aleckorver/KVR-ENCDR/README.md

# KVR-ENCDR
For development of hardware/firmware of a custom on axis encoder utilizing MLX90363 and M0+ to create a system with multiple simultaneous common encoder outputs (CANbus, PWM, A Vout, Push - Pull)
