aleckorver/KVR-ENCDR/SAMD21G18/Standard Board/EAGLE FILES/On Axis Encoder.dxf

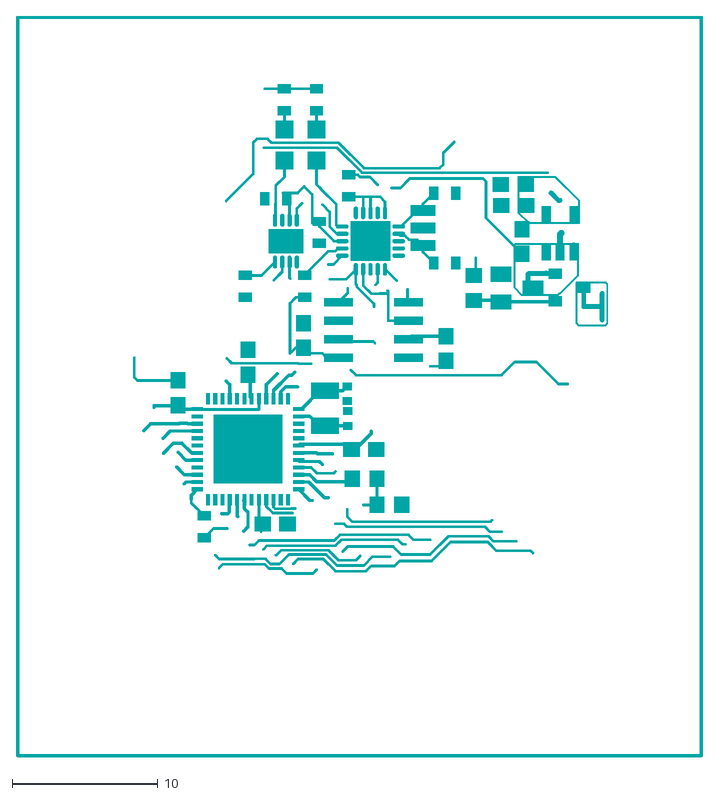
[picture p1: CAD file, 2020-12-15]
SAMD21G18/Standard Board/EAGLE FILES/On Axis Encoder.dxf
47.1 x 50.9
