aleckorver/KVR-ENCDR/STM32/Hardware/3D Models/AEV ENCODER 0.0.1 201219.step

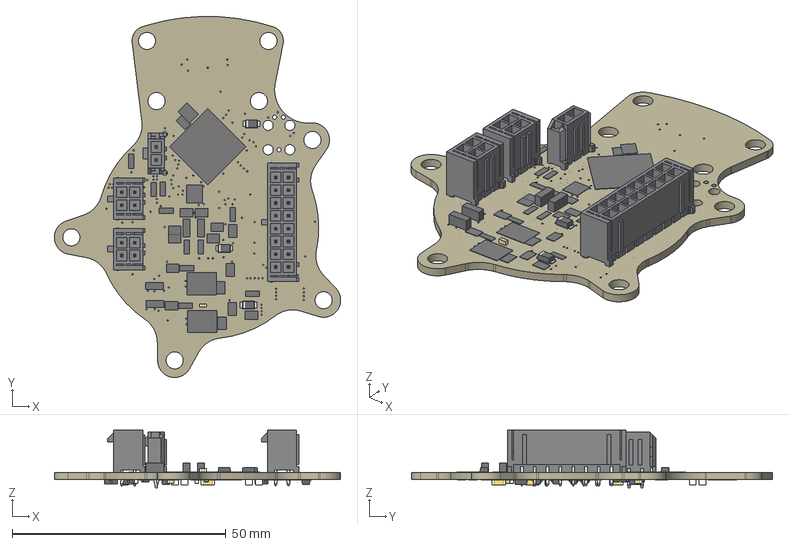
[picture p2: CAD file, 2020-12-28]
STM32/Hardware/3D Models/AEV ENCODER 0.0.1 201219.step
67.1 x 84.5 x 13.6 mm
Board
ICM-20648
SODFL3718X115 x 5
D0008A_N x 2
PG-DSO-8
SOT-23_3L_ONS
SOT23 x 5
SJ_2 x 4
LQFP64_STMLIB
CRY3225-4
C0603 x 31
C1206 x 7
FUSC1608X60N x 3
SO-8_S_LIT
C0603 (2) x 3
R0603 (1) x 42
SOT323-3_NFET x 2
MS5541C
SMC x 2
6620xx11122_PIN x 2
6620xx21122_PIN x 8
6620xx21122_PIN (1) x 8
6620xx21122_PIN2 x 8
CHIPLED_0805 x 10
R0603 x 4
C0603 (1)
