aleckorver/KVR-ENCDR/STM32/Hardware/Schematic PDF/KVR LABS - AEV ENCODER 0.0.1  - 201227.pdf

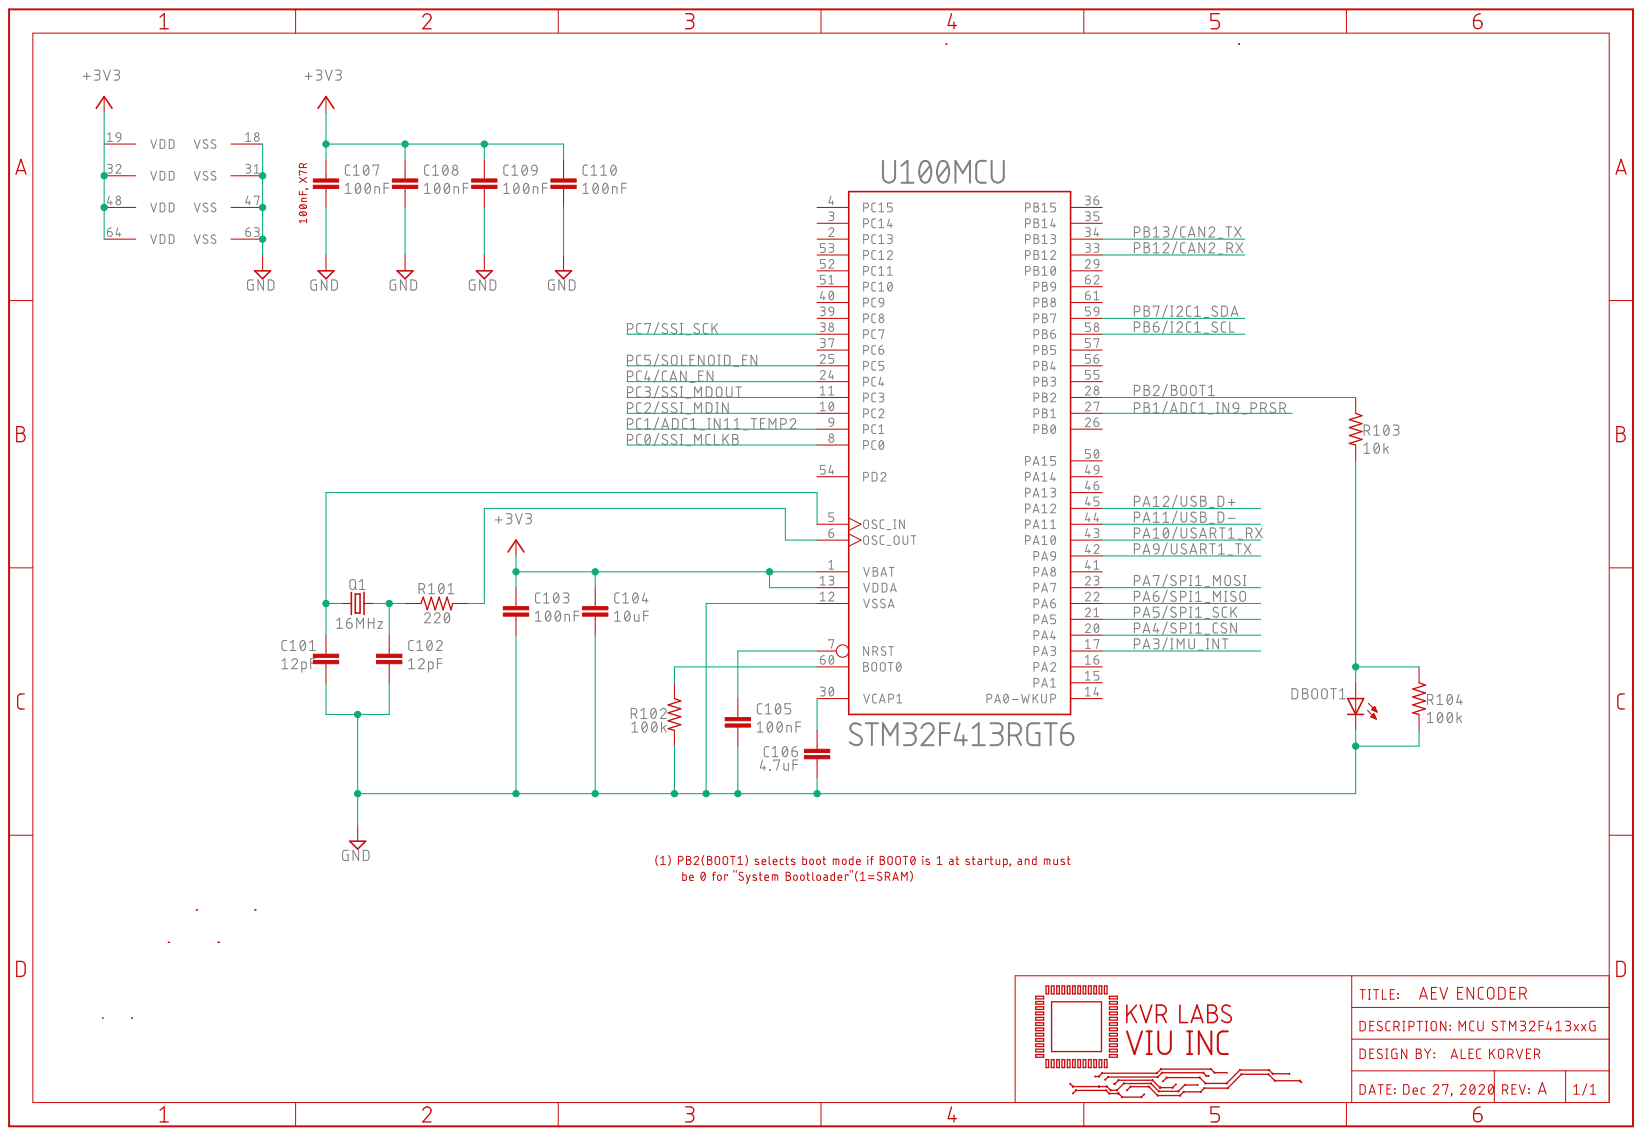
[picture p3: page 1]

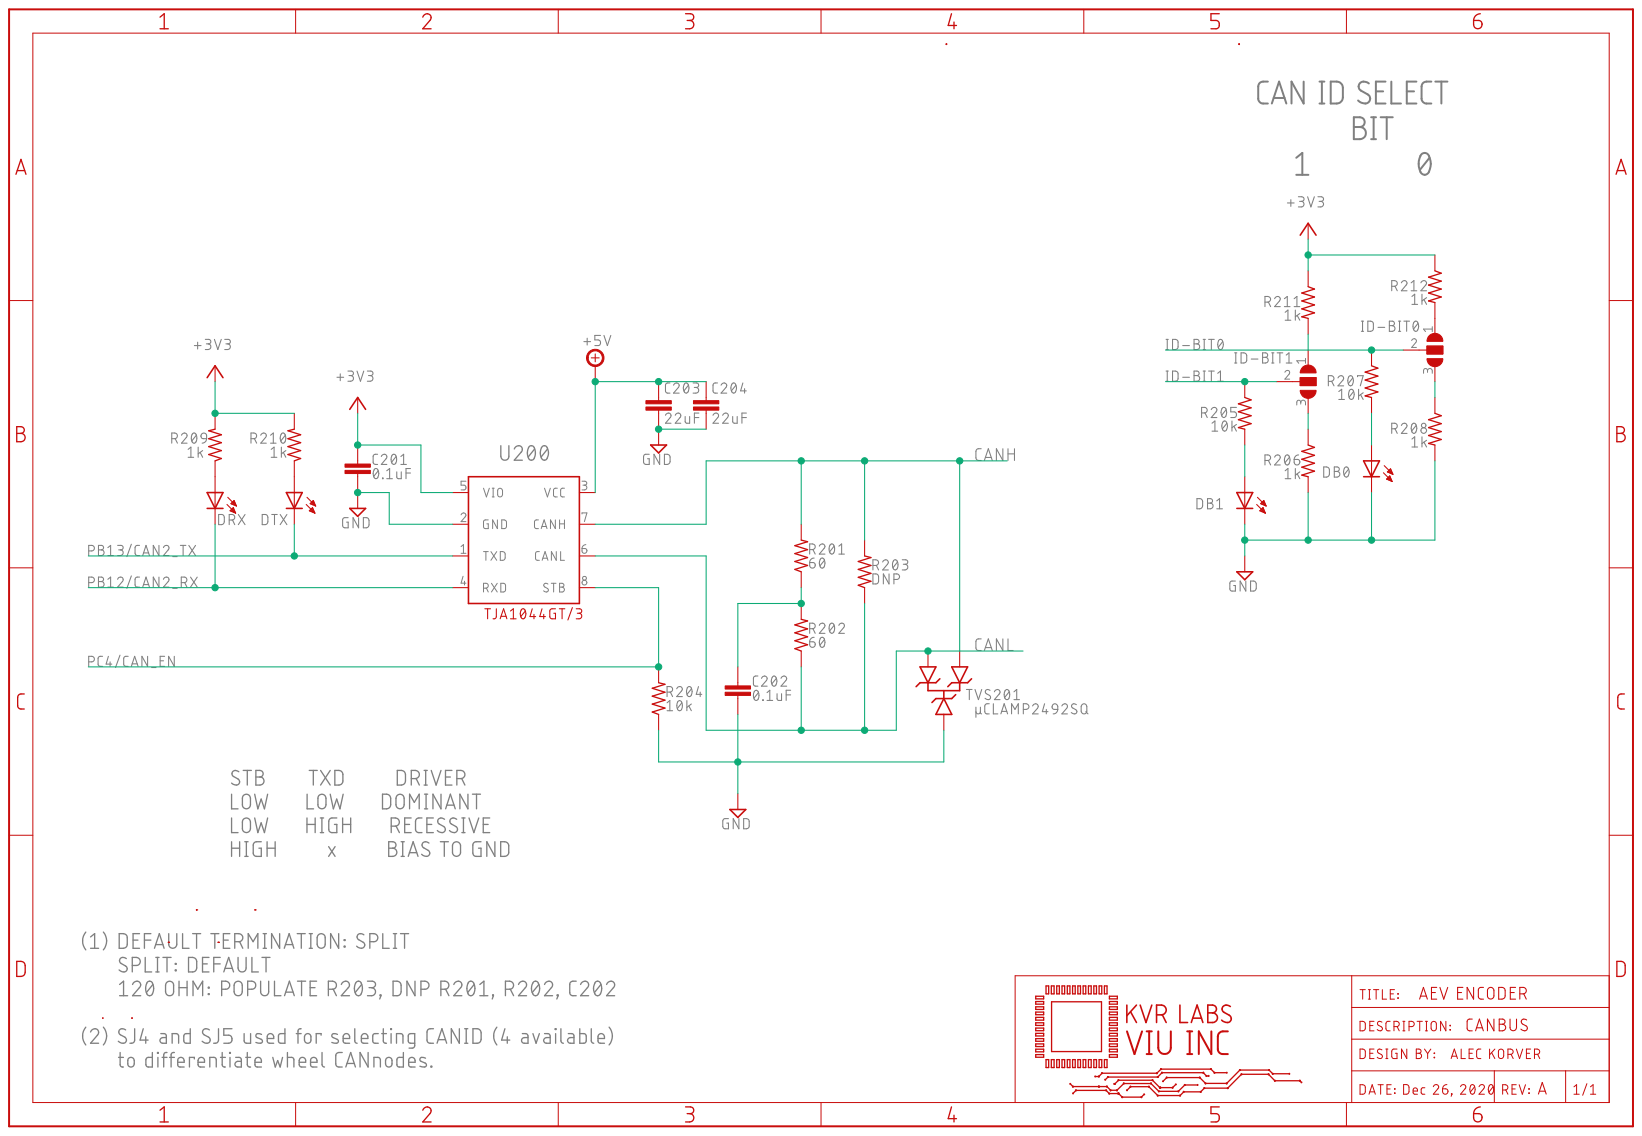
[picture p4: page 2]

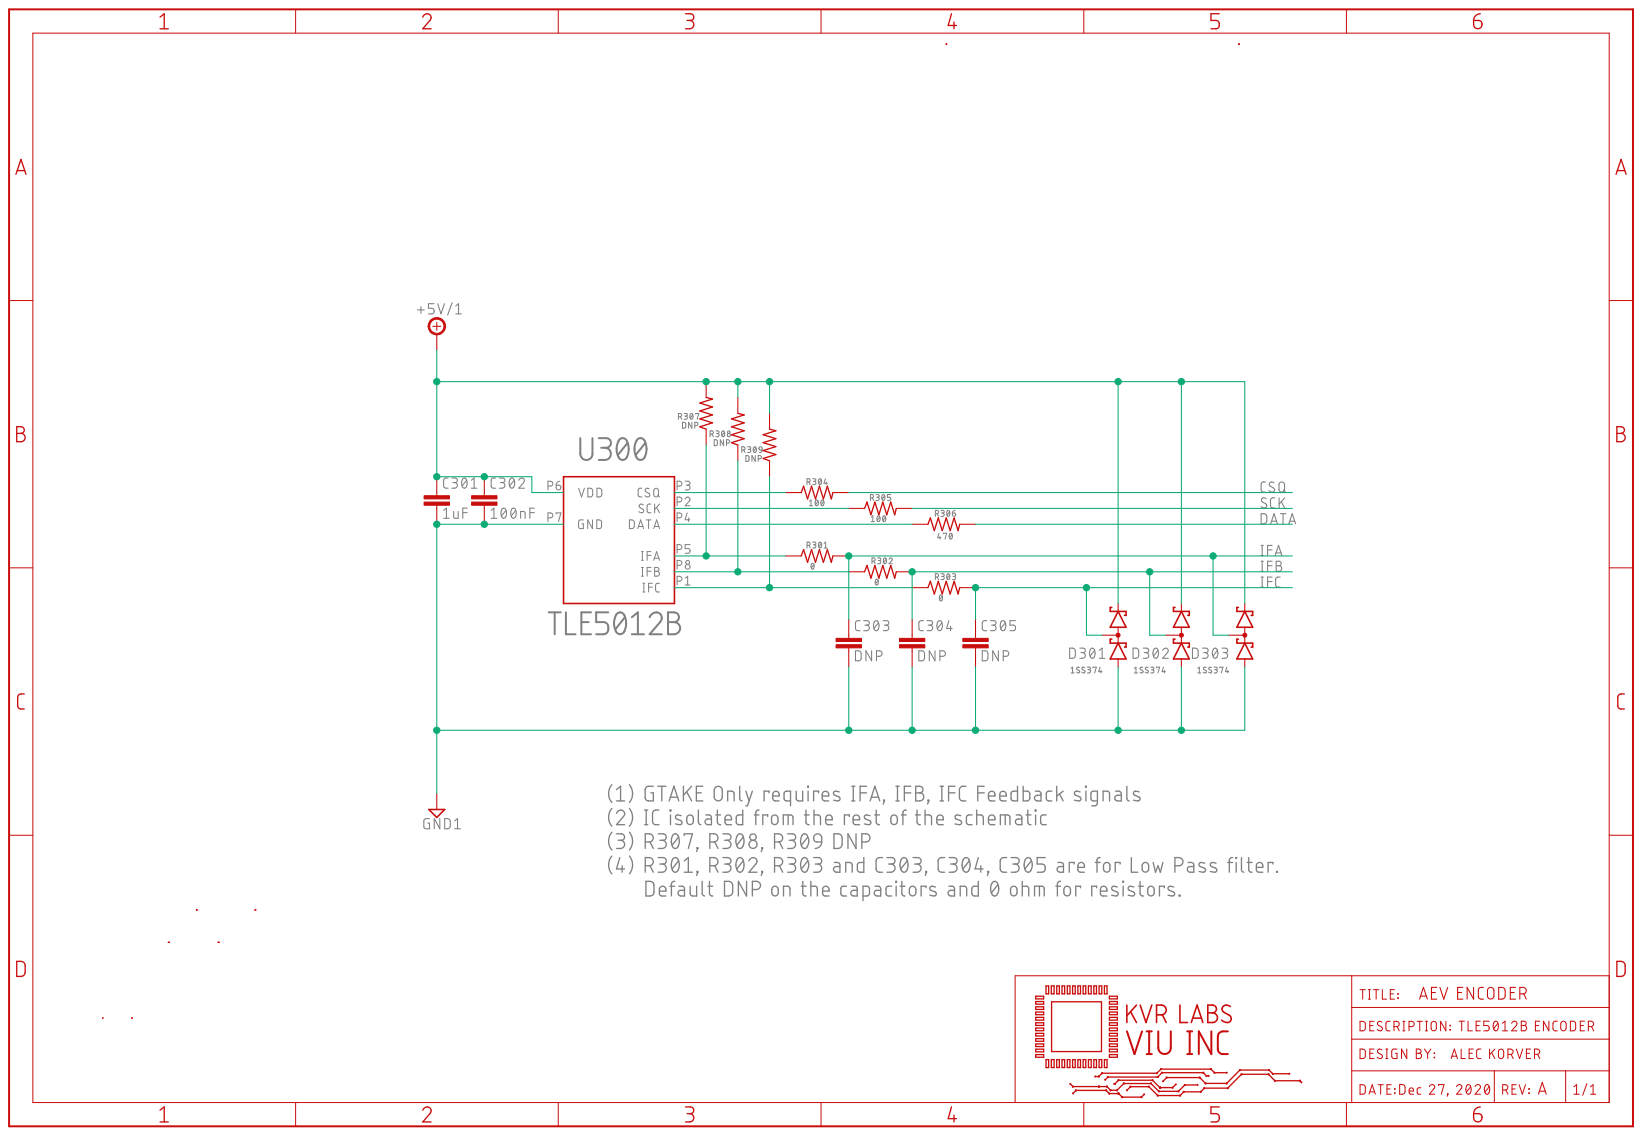
[picture p5: page 3]

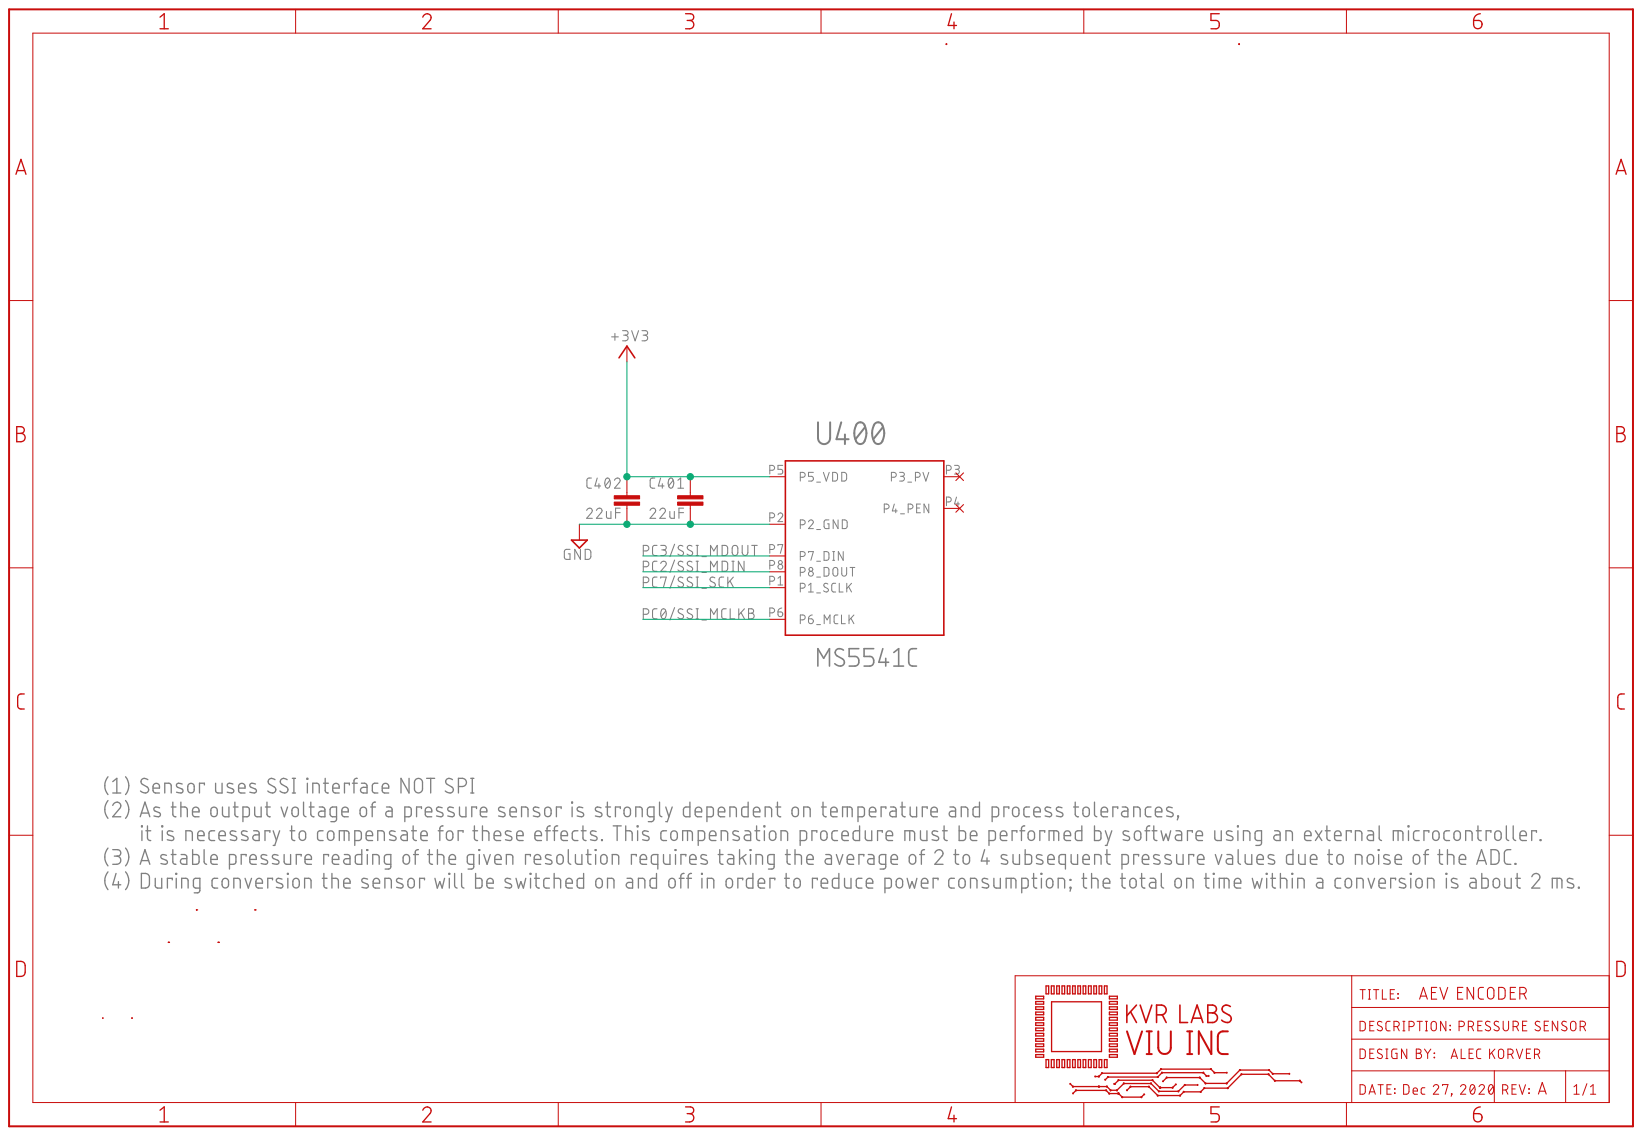
[picture p6: page 4]

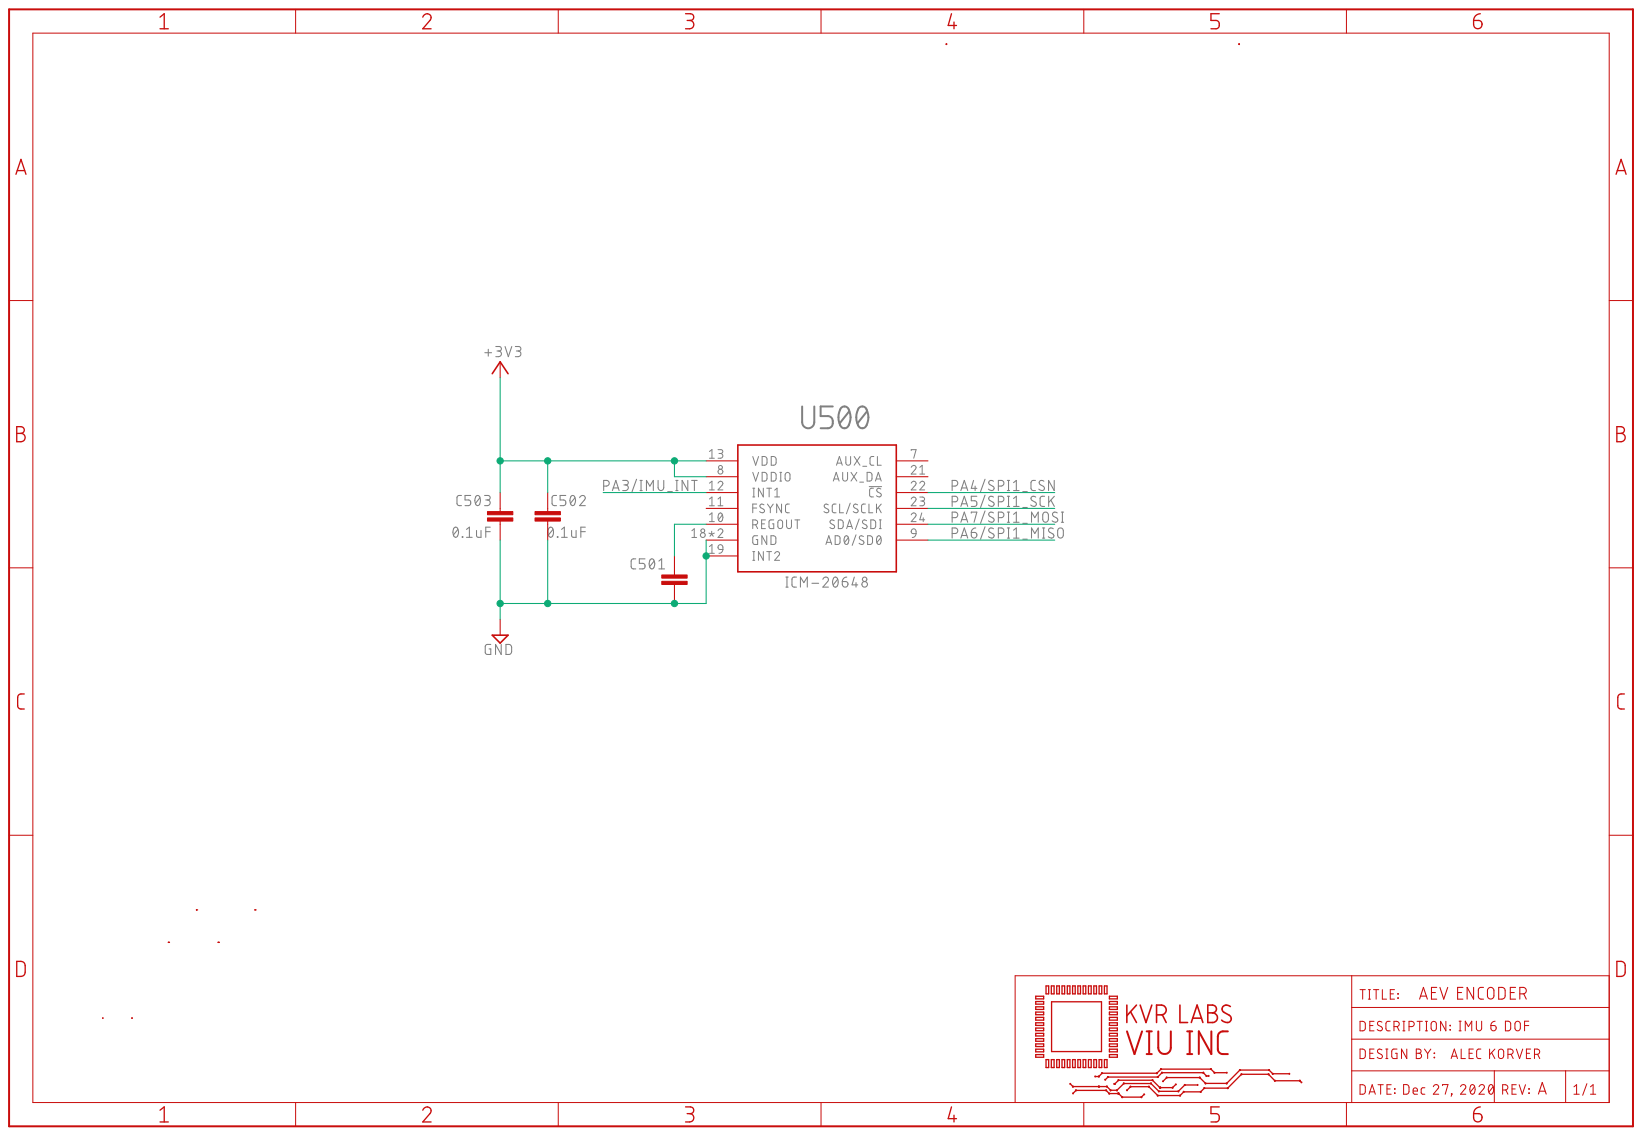
[picture p7: page 5]

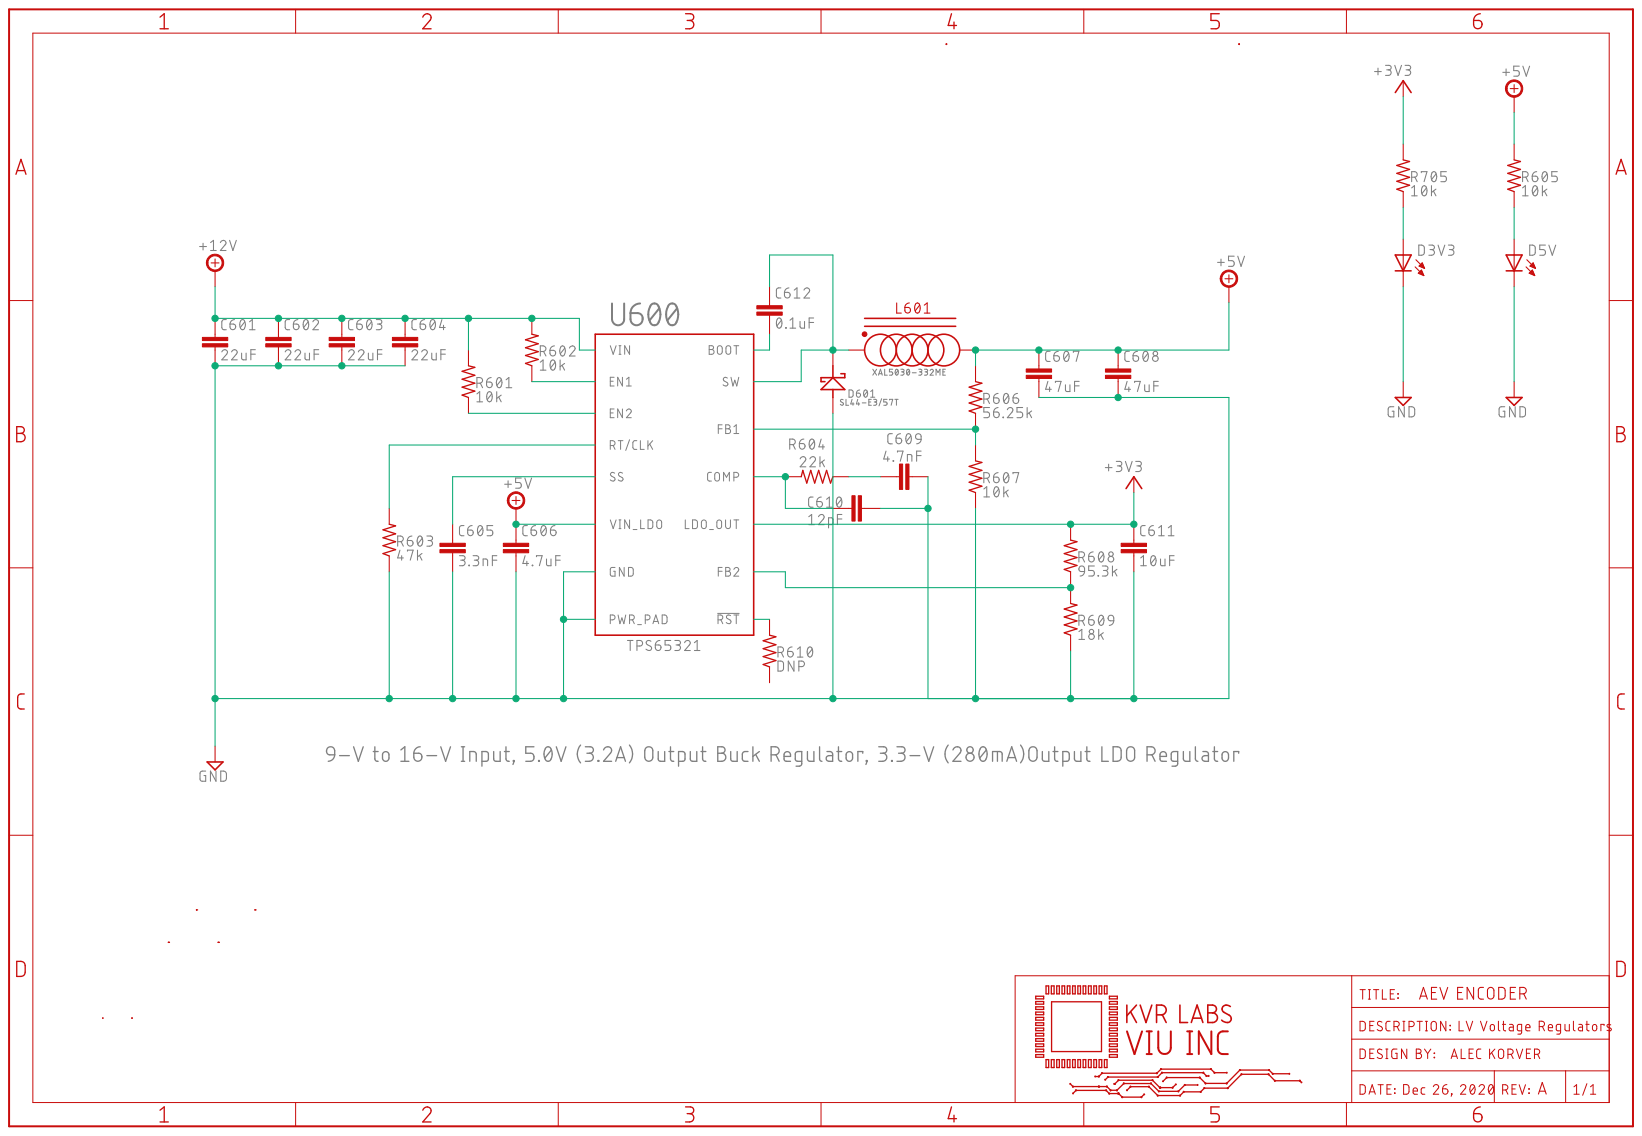
[picture p8: page 6]

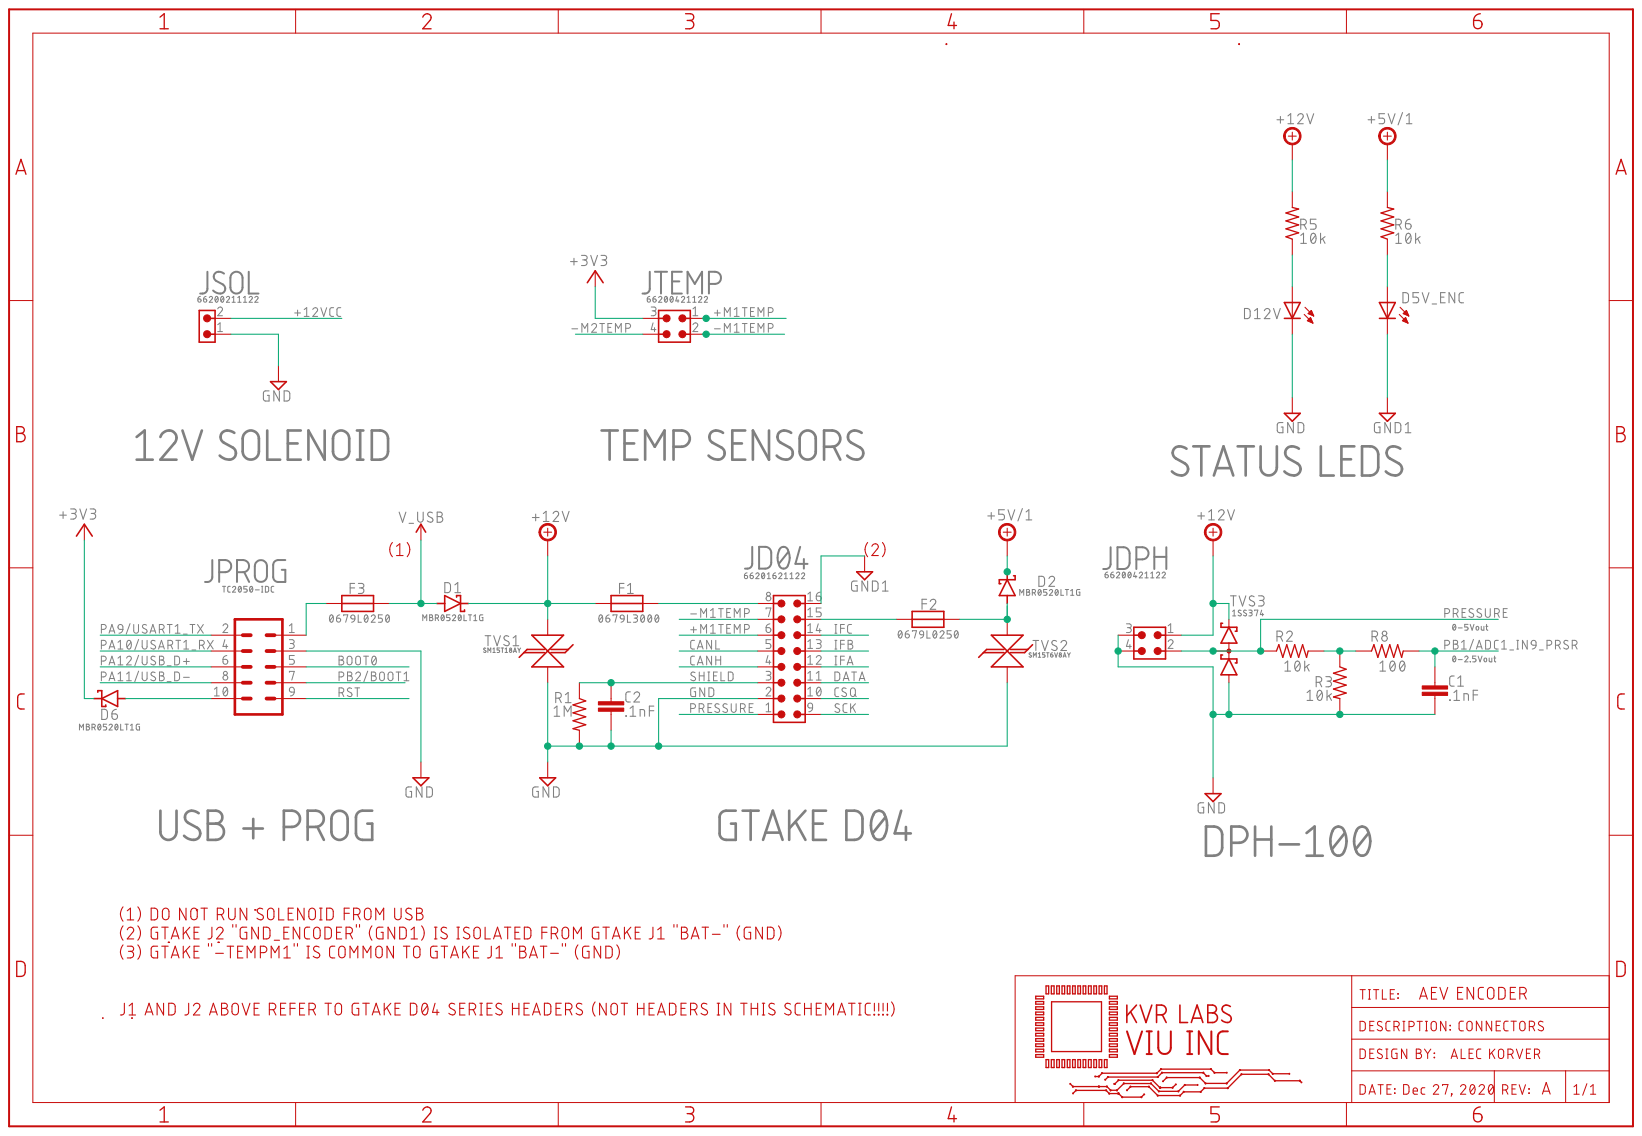
[picture p9: page 7]

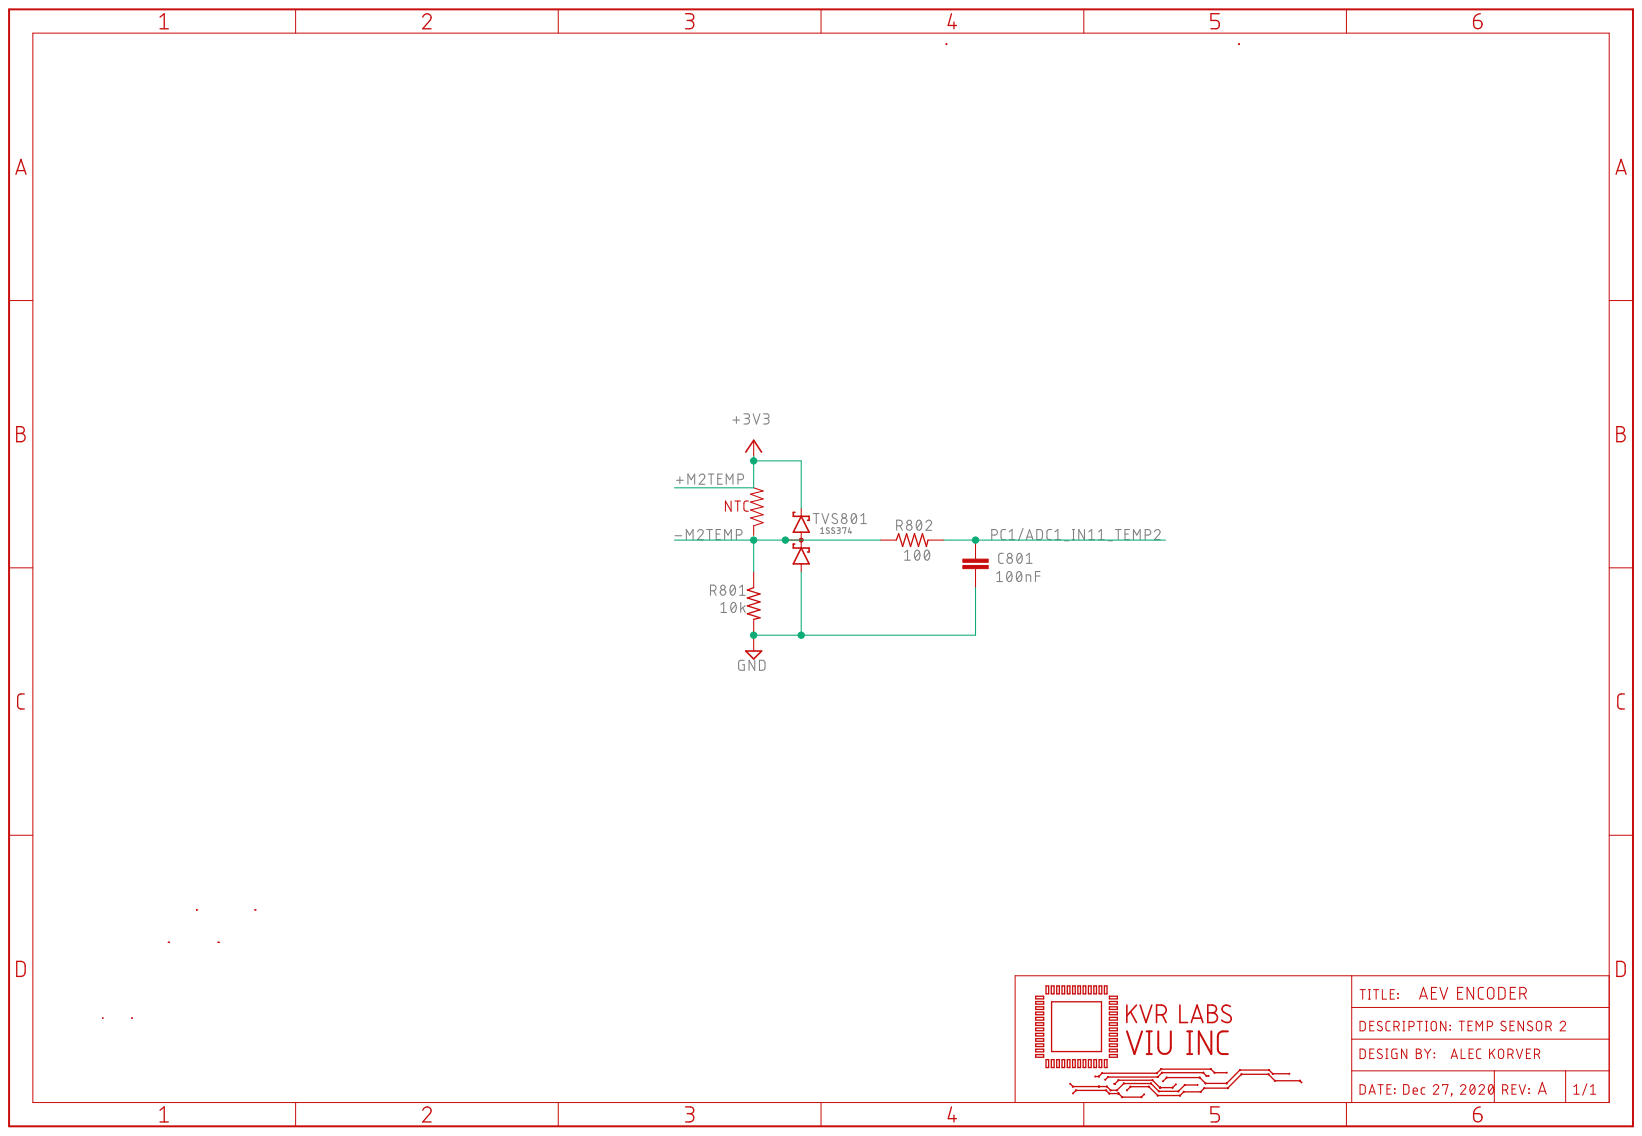
[picture p10: page 8]

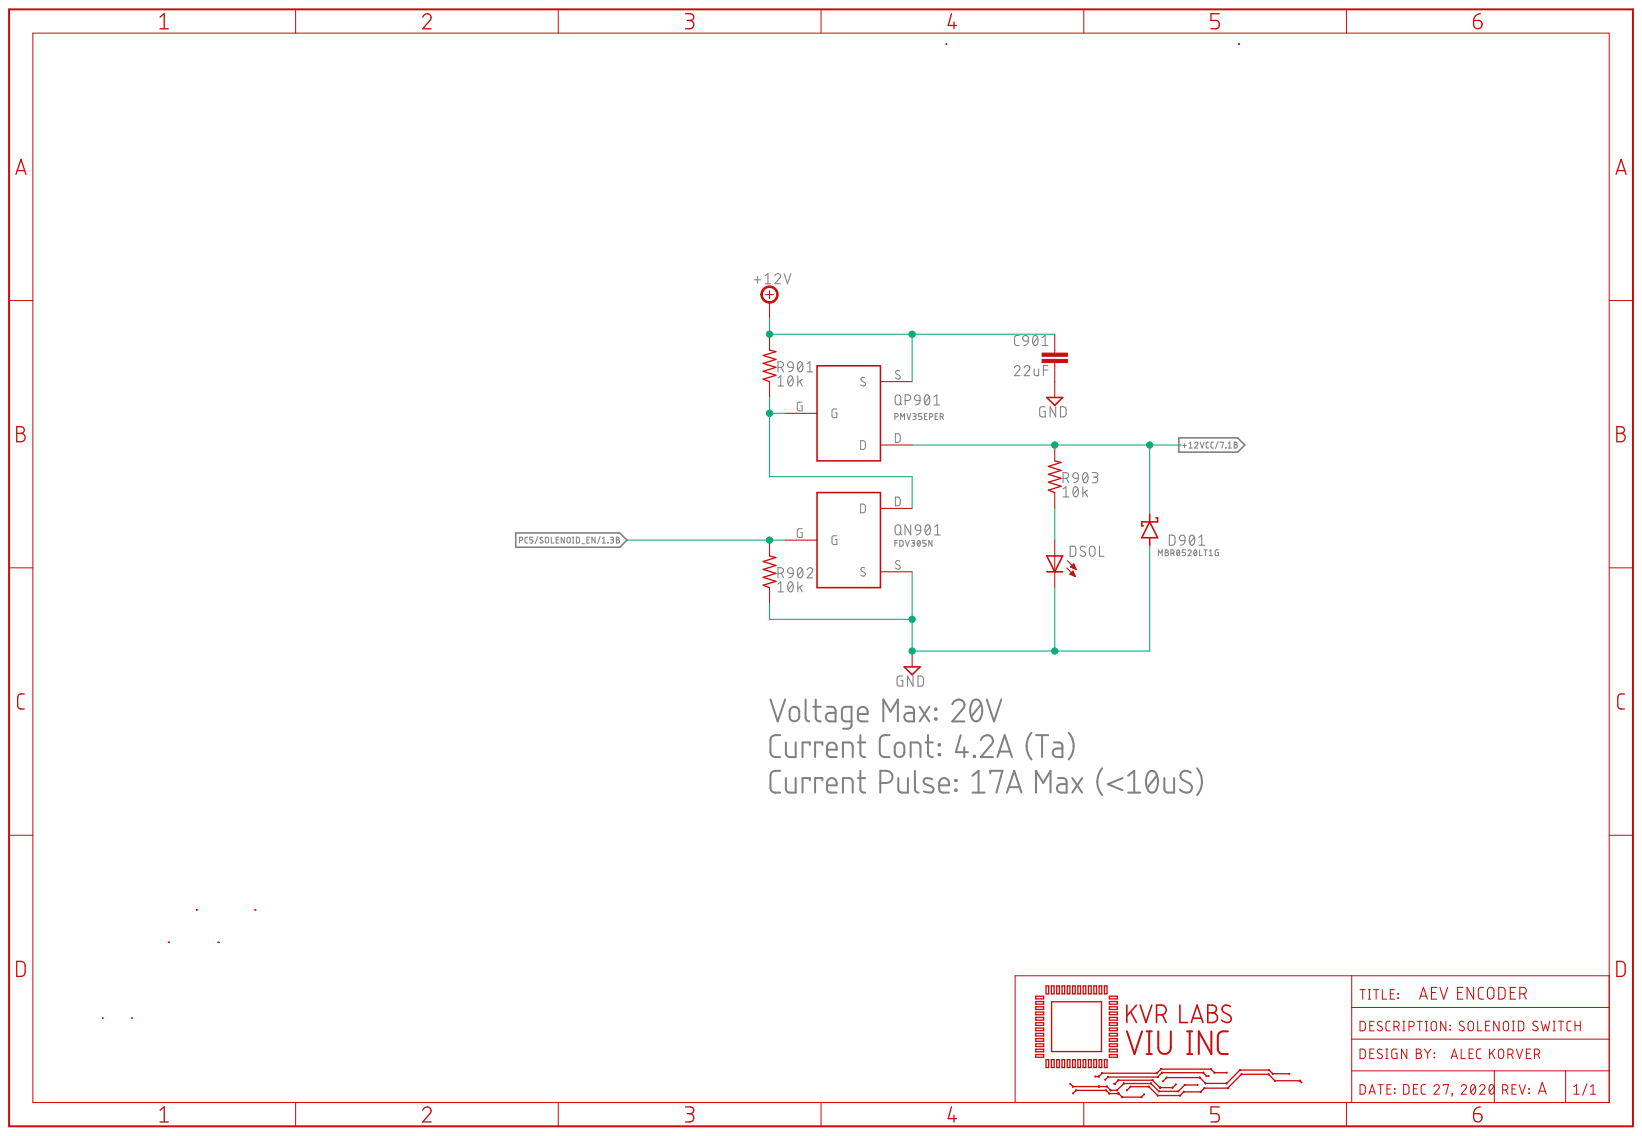
[picture p11: page 9]
