aleckorver/KVR-ENCDR/STM32/Hardware/Eagle Files/KVR LABS - AEV ENCODER 1.01-STM32.brd

## EAGLE design STM32/Hardware/Eagle Files/KVR LABS - AEV ENCODER 1.01-STM32.brd (2020-12-28)

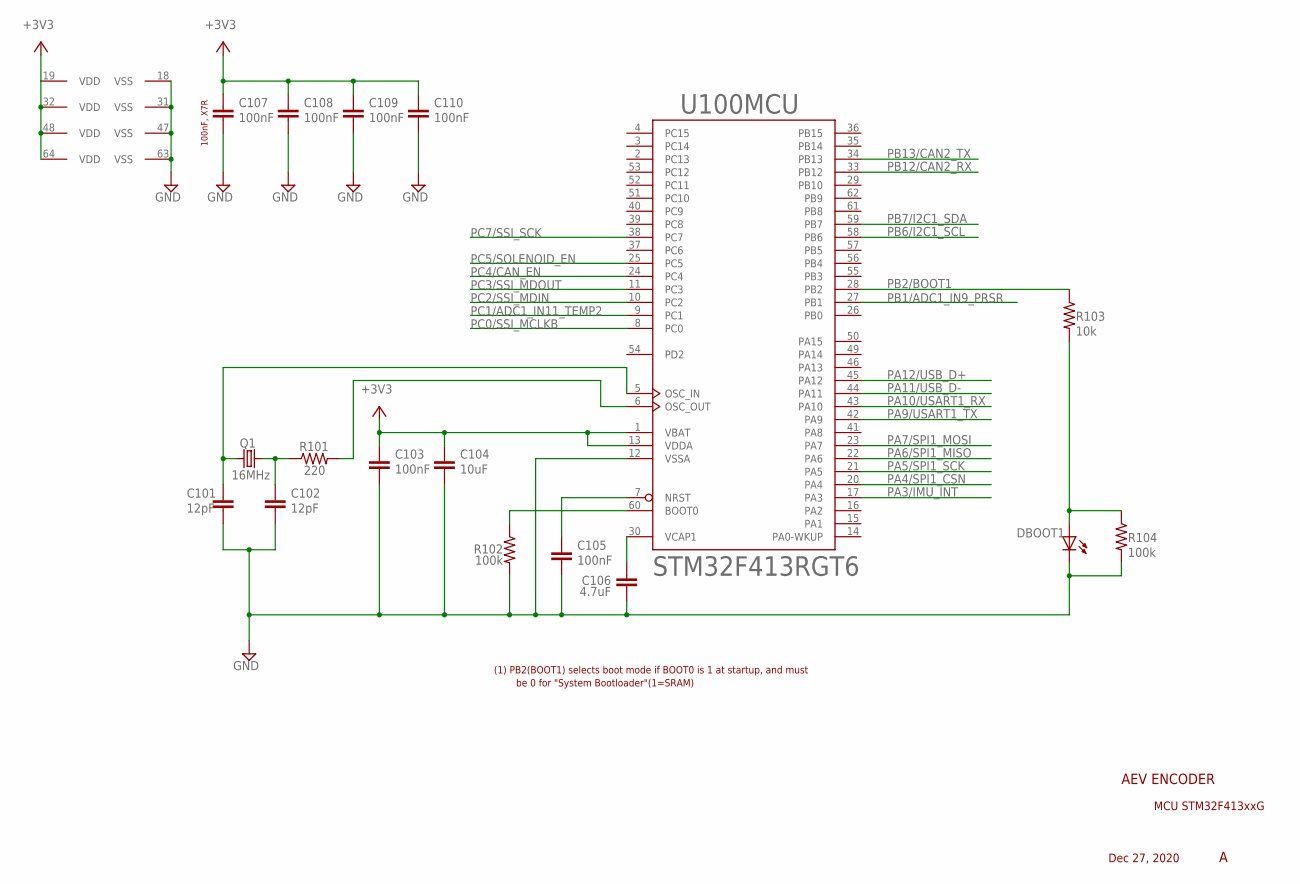
[picture p26: schematic KVR LABS - AEV ENCODER 1.01-STM32.sch, sheet 1, STM32F413RGT6]

Parts:
C101, C102: 12pF; C0603
C103, C105, C107, C108, C109, C110: 100nF; C0603
C104: 10uF; C0603
C106: 4.7uF; C0603
DBOOT1: LEDCHIPLED_0805; CHIPLED_0805
Q1: 16MHz; CRY3225-4
R101: 220; R0603
R102, R104: 100k; R0603
R103: 10k; R0603
U100: STM32F413RGT6; LQFP64_STMLIB

Connections:
+3V3: C103.1, C104.1, C107.1, C108.1, C109.1, C110.1, U100.1 (VBAT), U100.13 (VDDA), U100.19 (VDD), U100.32 (VDD), U100.48 (VDD), U100.64 (VDD); also elsewhere on the board
BOOT0: R102.1, U100.60 (BOOT0); also elsewhere on the board
GND: C101.2, C102.2, C103.2, C104.2, C105.2, C106.2, C107.2, C108.2, C109.2, C110.2, DBOOT1.C, R102.2, R104.2, U100.12 (VSSA), U100.18 (VSS), U100.31 (VSS), U100.47 (VSS), U100.63 (VSS); also elsewhere on the board
unnamed: DBOOT1.A, R103.2, R104.1
unnamed: R101.2, U100.6 (OSC_OUT)
NRST: C105.1, U100.7 (NRST)
OSC_IN: C101.1, Q1.3 (2), U100.5 (OSC_IN)
OSC_OUT: C102.1, Q1.1, R101.1
PA3/IMU_INT: U100.17 (PA3); also elsewhere on the board
PA4/SPI1_CSN: U100.20 (PA4); also elsewhere on the board
PA5/SPI1_SCK: U100.21 (PA5); also elsewhere on the board
PA6/SPI1_MISO: U100.22 (PA6); also elsewhere on the board
PA7/SPI1_MOSI: U100.23 (PA7); also elsewhere on the board
PA9/USART1_TX: U100.42 (PA9); also elsewhere on the board
PA10/USART1_RX: U100.43 (PA10); also elsewhere on the board
PA11/USB_D-: U100.44 (PA11); also elsewhere on the board
PA12/USB_D+: U100.45 (PA12); also elsewhere on the board
PB1/ADC1_IN9_PRSR: U100.27 (PB1); also elsewhere on the board
PB2/BOOT1: R103.1, U100.28 (PB2); also elsewhere on the board
PB6/I2C1_SCL: U100.58 (PB6)
PB7/I2C1_SDA: U100.59 (PB7)
PB12/CAN2_RX: U100.33 (PB12); also elsewhere on the board
PB13/CAN2_TX: U100.34 (PB13); also elsewhere on the board
PC0/SSI_MCLKB: U100.8 (PC0); also elsewhere on the board
PC1/ADC1_IN11_TEMP2: U100.9 (PC1); also elsewhere on the board
PC2/SSI_MDIN: U100.10 (PC2); also elsewhere on the board
PC3/SSI_MDOUT: U100.11 (PC3); also elsewhere on the board
PC4/CAN_EN: U100.24 (PC4); also elsewhere on the board
PC5/SOLENOID_EN: U100.25 (PC5); also elsewhere on the board
PC7/SSI_SCK: U100.38 (PC7); also elsewhere on the board
VCAP: C106.1, U100.30 (VCAP1)

Notes on the sheet:
AEV ENCODER
MCU STM32F413xxG
Dec 27, 2020
100nF, X7R
(1) PB2(BOOT1) selects boot mode if BOOT0 is 1 at startup, and must
be 0 for "System Bootloader"(1=SRAM)

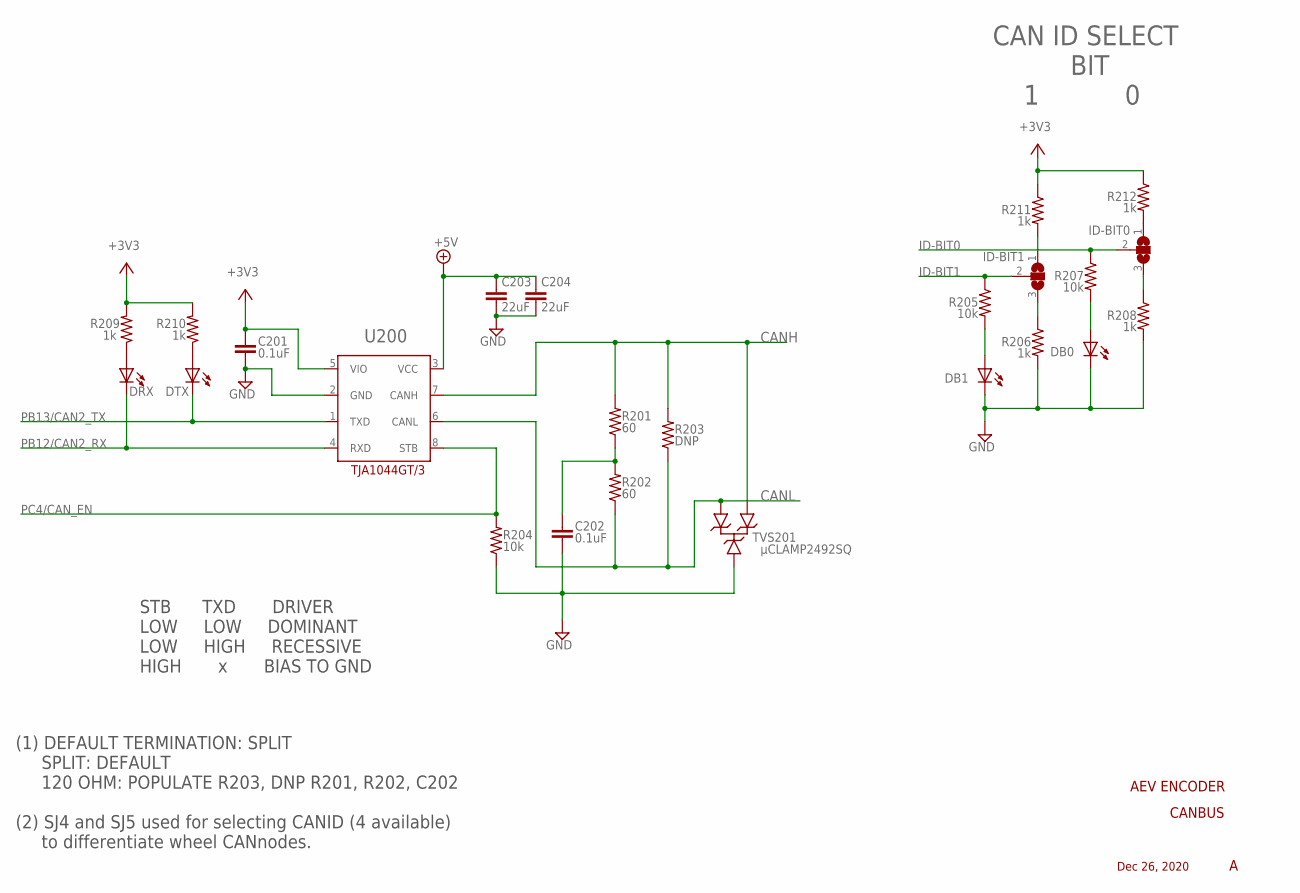
[picture p27: schematic KVR LABS - AEV ENCODER 1.01-STM32.sch, sheet 2, CANbus]

Parts:
C201, C202: 0.1uF; C0603
C203, C204: 22uF; C1206
D201: μCLAMP2492SQ; SOT-23_3L_ONS
DB0, DB1: LEDCHIPLED_0805; CHIPLED_0805
DRX: LEDCHIPLED_0805; CHIPLED_0805
DTX: LEDCHIPLED_0805; CHIPLED_0805
ID-BIT0, ID-BIT1: SJ2W; SJ_2
R201, R202: 60; R0603
R203: DNP; R0603
R204, R205, R207: 10k; R0603
R206, R208, R209, R210, R211, R212: 1k; R0603
U200: TJA1044GT/3; SO-8_S_LIT

Connections:
+3V3: C201.1, R209.2, R210.2, R211.1, R212.1, U200.5 (VIO); also elsewhere on the board
+5V: C203.1, C204.1, U200.3 (VCC); also elsewhere on the board
CANH: D201.2, R201.2, R203.2, U200.7 (CANH); also elsewhere on the board
CANL: D201.1, R202.1, R203.1, U200.6 (CANL); also elsewhere on the board
GND: C201.2, C202.2, C203.2, C204.2, D201.3, DB0.C, DB1.C, R204.1, R206.2, R208.2, U200.2 (GND); also elsewhere on the board
ID-BIT0: ID-BIT0.2, R207.1
ID-BIT1: ID-BIT1.2, R205.1
unnamed: ID-BIT1.3, R206.1
unnamed: ID-BIT0.3, R208.1
unnamed: DB0.A, R207.2
unnamed: DB1.A, R205.2
unnamed: ID-BIT1.1, R211.2
unnamed: ID-BIT0.1, R212.2
unnamed: DRX.A, R209.1
unnamed: DTX.A, R210.1
PB12/CAN2_RX: DRX.C, U200.4 (RXD); also elsewhere on the board
PB13/CAN2_TX: DTX.C, U200.1 (TXD); also elsewhere on the board
PC4/CAN_EN: R204.2, U200.8 (STB); also elsewhere on the board
SPLIT: C202.1, R201.1, R202.2

Notes on the sheet:
CANBUS
AEV ENCODER
Dec 26, 2020
(1) DEFAULT TERMINATION: SPLIT SPLIT: DEFAULT 120 OHM: POPULATE R203, DNP R201, R202, C202 (2) SJ4 and SJ5 used for selecting CANID (4 available) to differentiate wheel CANnodes.
CAN ID SELECT BIT 1 0
TVS201
U200
STB TXD DRIVER LOW LOW DOMINANT LOW HIGH RECESSIVE HIGH x BIAS TO GND

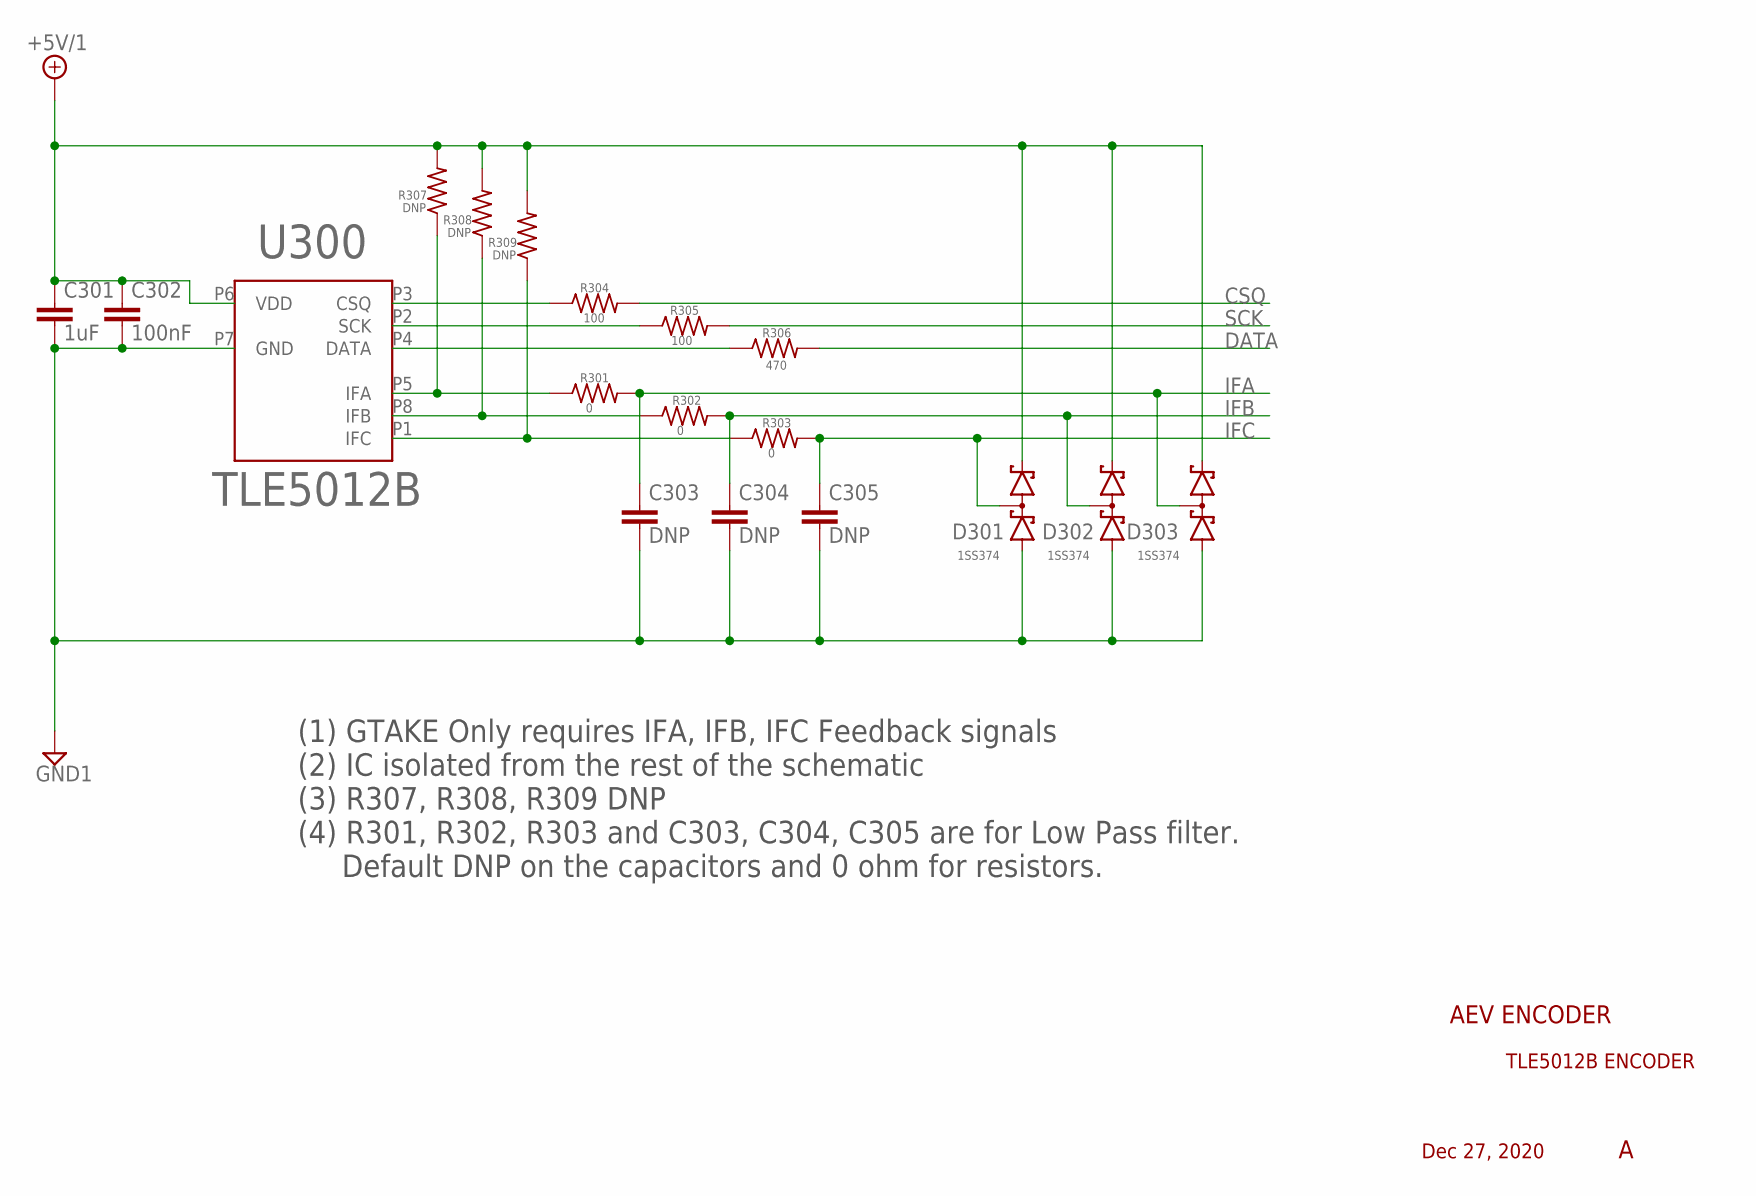
[picture p28: schematic KVR LABS - AEV ENCODER 1.01-STM32.sch, sheet 3, ABSOLUTE ENCODER]

Parts:
C301: 1uF; C0603
C302: 100nF; C0603
C303, C304, C305: DNP; C0603
D301, D302, D303: BAS70-04; SOT23
R301, R302, R303: 0; R0603
R304, R305: 100; R0603
R306: 470; R0603
R307, R308, R309: DNP; R0603
U300: TLE5012B; PG-DSO-8

Connections:
+5V/1: C301.1, C302.1, D301.2 (C2), D302.2 (C2), D303.2 (C2), R307.2, R308.2, R309.2, U300.P6 (VDD); also elsewhere on the board
CSQ: R304.2; also elsewhere on the board
DATA: R306.2; also elsewhere on the board
GND1: C301.2, C302.2, C303.2, C304.2, C305.2, D301.1 (A1), D302.1 (A1), D303.1 (A1), U300.P7 (GND); also elsewhere on the board
IFA: C303.1, D303.3 (C1A2), R301.2; also elsewhere on the board
IFB: C304.1, D302.3 (C1A2), R302.2; also elsewhere on the board
IFC: C305.1, D301.3 (C1A2), R303.2; also elsewhere on the board
unnamed: R304.1, U300.P3 (CSQ)
unnamed: R305.1, U300.P2 (SCK)
unnamed: R306.1, U300.P4 (DATA)
unnamed: R301.1, R307.1, U300.P5 (IFA)
unnamed: R302.1, R308.1, U300.P8 (IFB)
unnamed: R303.1, R309.1, U300.P1 (IFC)
SCK: R305.2; also elsewhere on the board

Notes on the sheet:
AEV ENCODER
TLE5012B ENCODER
Dec 27, 2020
U300
(1) GTAKE Only requires IFA, IFB, IFC Feedback signals (2) IC isolated from the rest of the schematic (3) R307, R308, R309 DNP (4) R301, R302, R303 and C303, C304, C305 are for Low Pass filter. Default DNP on the capacitors and 0 ohm for resistors.

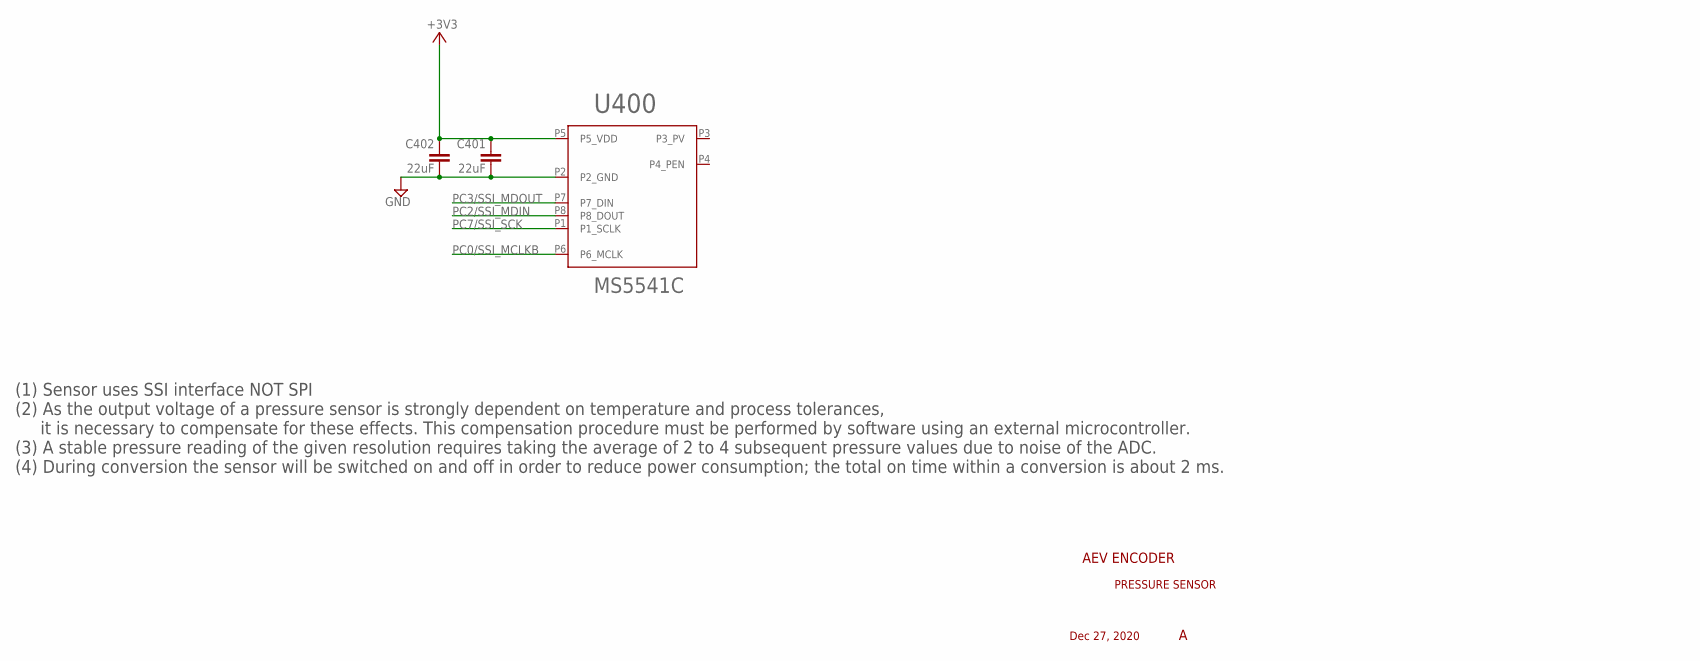
[picture p29: schematic KVR LABS - AEV ENCODER 1.01-STM32.sch, sheet 4, PRESSURE SENSOR]

Parts:
C401, C402: 22uF; C1206
U400: MS5541C

Connections:
+3V3: C401.1, C402.1, U400.P5 (P5_VDD); also elsewhere on the board
GND: C401.2, C402.2, U400.P2 (P2_GND); also elsewhere on the board
PC0/SSI_MCLKB: U400.P6 (P6_MCLK); also elsewhere on the board
PC2/SSI_MDIN: U400.P8 (P8_DOUT); also elsewhere on the board
PC3/SSI_MDOUT: U400.P7 (P7_DIN); also elsewhere on the board
PC7/SSI_SCK: U400.P1 (P1_SCLK); also elsewhere on the board

Notes on the sheet:
AEV ENCODER
PRESSURE SENSOR
Dec 27, 2020
(1) Sensor uses SSI interface NOT SPI (2) As the output voltage of a pressure sensor is strongly dependent on temperature and process tolerances, it is necessary to compensate for these effects. This compensation procedure must be performed by software using an external microcontroller. (3) A stabl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

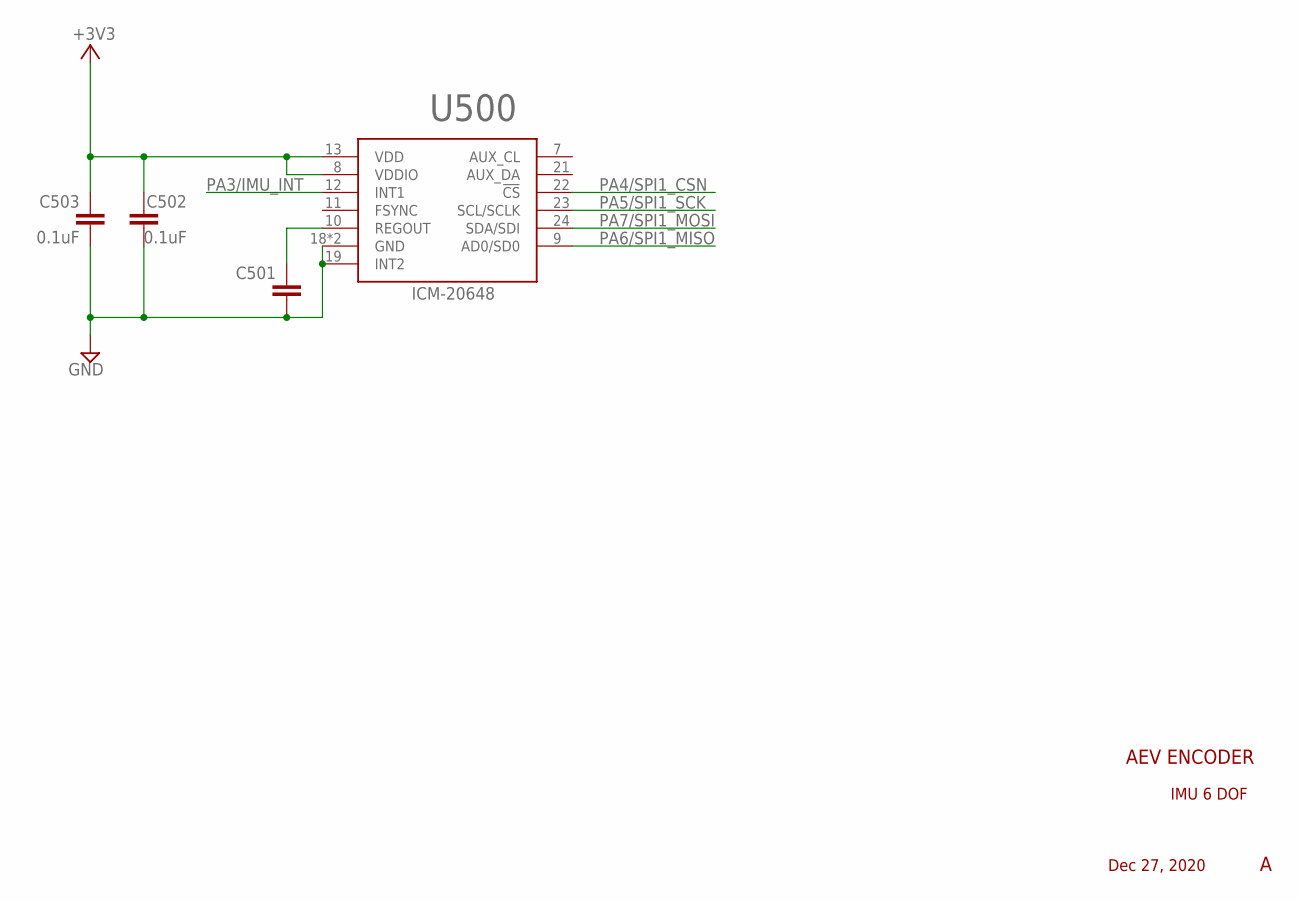
[picture p30: schematic KVR LABS - AEV ENCODER 1.01-STM32.sch, sheet 5, IMU - ICM20648]

Parts:
C501, C502, C503: 0.1uF; C0603
U500: ICM-20648

Connections:
+3V3: C502.1, C503.1, U500.8 (VDDIO), U500.13 (VDD); also elsewhere on the board
GND: C501.2, C502.2, C503.2, U500.18 (GND), U500.19 (INT2), U500.20 (GND); also elsewhere on the board
PA3/IMU_INT: U500.12 (INT1); also elsewhere on the board
PA4/SPI1_CSN: U500.22 (!CS); also elsewhere on the board
PA5/SPI1_SCK: U500.23 (SCL/SCLK); also elsewhere on the board
PA6/SPI1_MISO: U500.9 (AD0/SD0); also elsewhere on the board
PA7/SPI1_MOSI: U500.24 (SDA/SDI); also elsewhere on the board
REGOUT2: C501.1, U500.10 (REGOUT)

Notes on the sheet:
AEV ENCODER
IMU 6 DOF
Dec 27, 2020

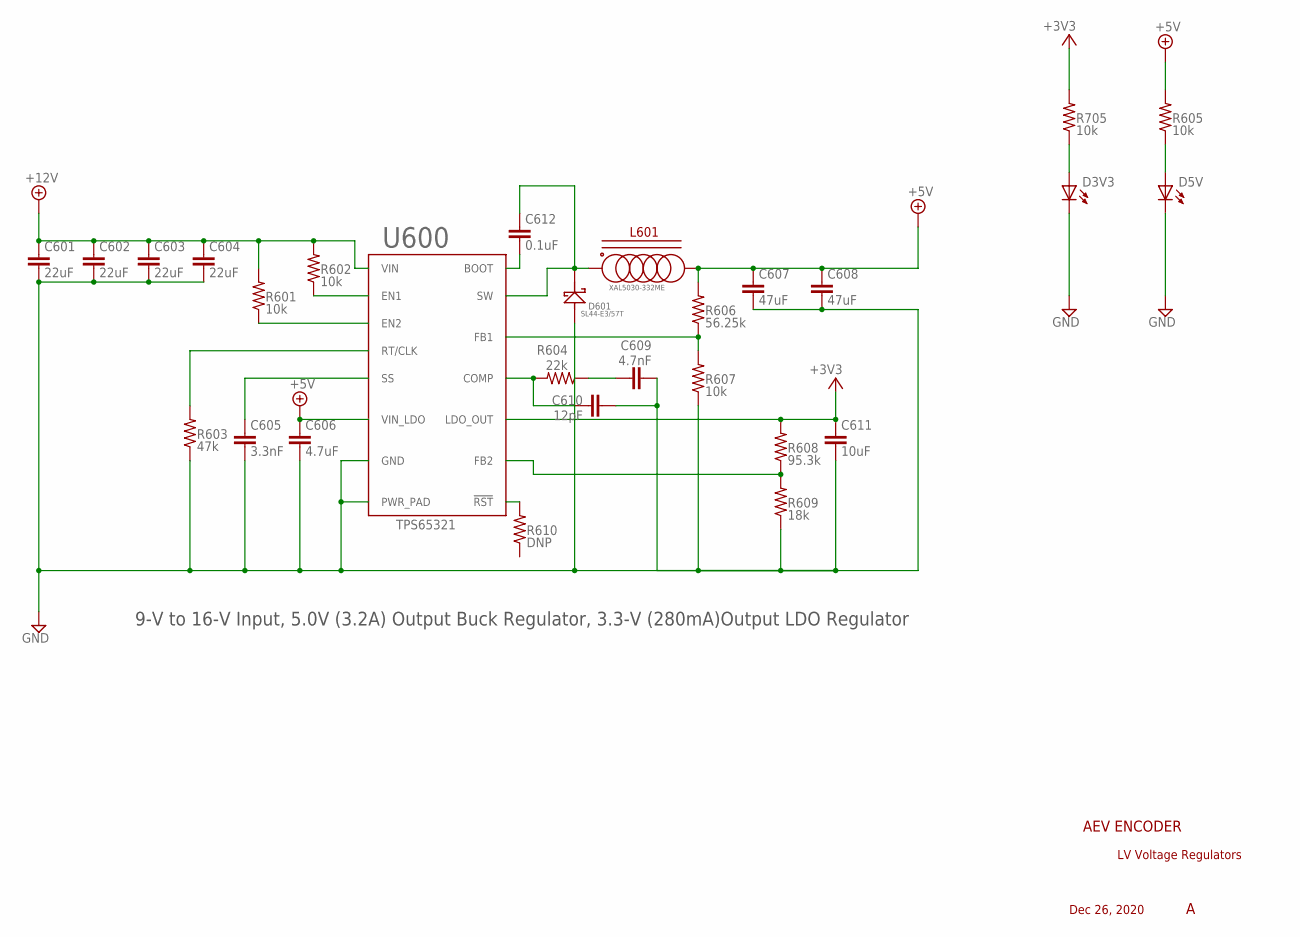
[picture p31: schematic KVR LABS - AEV ENCODER 1.01-STM32.sch, sheet 6, Voltage Regulators]

Parts:
C601, C602, C603, C604: 22uF; C0603
C605: 3.3nF; C0603
C606: 4.7uF; C0603
C607, C608: 47uF; C1210
C609: 4.7nF; C0603
C610: 12pF; C0603
C611: 10uF; C0603
C612: 0.1uF; C0603
D3V3, D5V: LEDCHIPLED_0805; CHIPLED_0805
D601: SL44; DO-214AB
L601: XAL5030
R601, R602, R605, R607, R705: 10k; R0603
R603: 47k; R0603
R604: 22k; R0603
R606: 56.25k; R0603
R608: 95.3k; R0603
R609: 18k; R0603
R610: DNP; R0603
U600: TPS65321-Q1; 14-HTSSOP

Connections:
+3V3: C611.1, R608.2, R705.2, U600.P4 (LDO_OUT); also elsewhere on the board
+5V: C606.1, C607.1, C608.1, L601.P2, R605.2, R606.2, U600.P3 (VIN_LDO); also elsewhere on the board
+12V: C601.1, C602.1, C603.1, C604.1, R601.2, R602.2, U600.P2 (VIN); also elsewhere on the board
BOOT: C612.2, U600.P1 (BOOT)
COMP: C610.1, R604.2, U600.P12 (COMP)
EN1: R602.1, U600.P8 (EN1)
EN2: R601.1, U600.P7 (EN2)
FB1: R606.1, R607.2, U600.P11 (FB1)
FB2: R608.1, R609.2, U600.P5 (FB2)
GND: C601.2, C602.2, C603.2, C604.2, C605.2, C606.2, C607.2, C608.2, C609.2, C610.2, C611.2, D3V3.C, D5V.C, D601.ANODE, R603.1, R607.1, R609.1, U600.P13 (GND), U600.P15 (PWR_PAD), U600.P16 (PWR_PAD), U600.P17 (PWR_PAD), U600.P18 (PWR_PAD), U600.P19 (PWR_PAD), U600.P20 (PWR_PAD), U600.P21 (PWR_PAD), U600.P22 (PWR_PAD), U600.P23 (PWR_PAD); also elsewhere on the board
unnamed: D3V3.A, R705.1
unnamed: D5V.A, R605.1
unnamed: C609.1, R604.1
unnamed: R610.2, U600.P6 (!RST)
RT/CLK: R603.2, U600.P9 (RT/CLK)
SS: C605.1, U600.P10 (SS)
SW: C612.1, D601.CATHODE, L601.P1, U600.P14 (SW)

Notes on the sheet:
AEV ENCODER
LV Voltage Regulators
9-V to 16-V Input, 5.0V (3.2A) Output Buck Regulator, 3.3-V (280mA)Output LDO Regulator
Dec 26, 2020

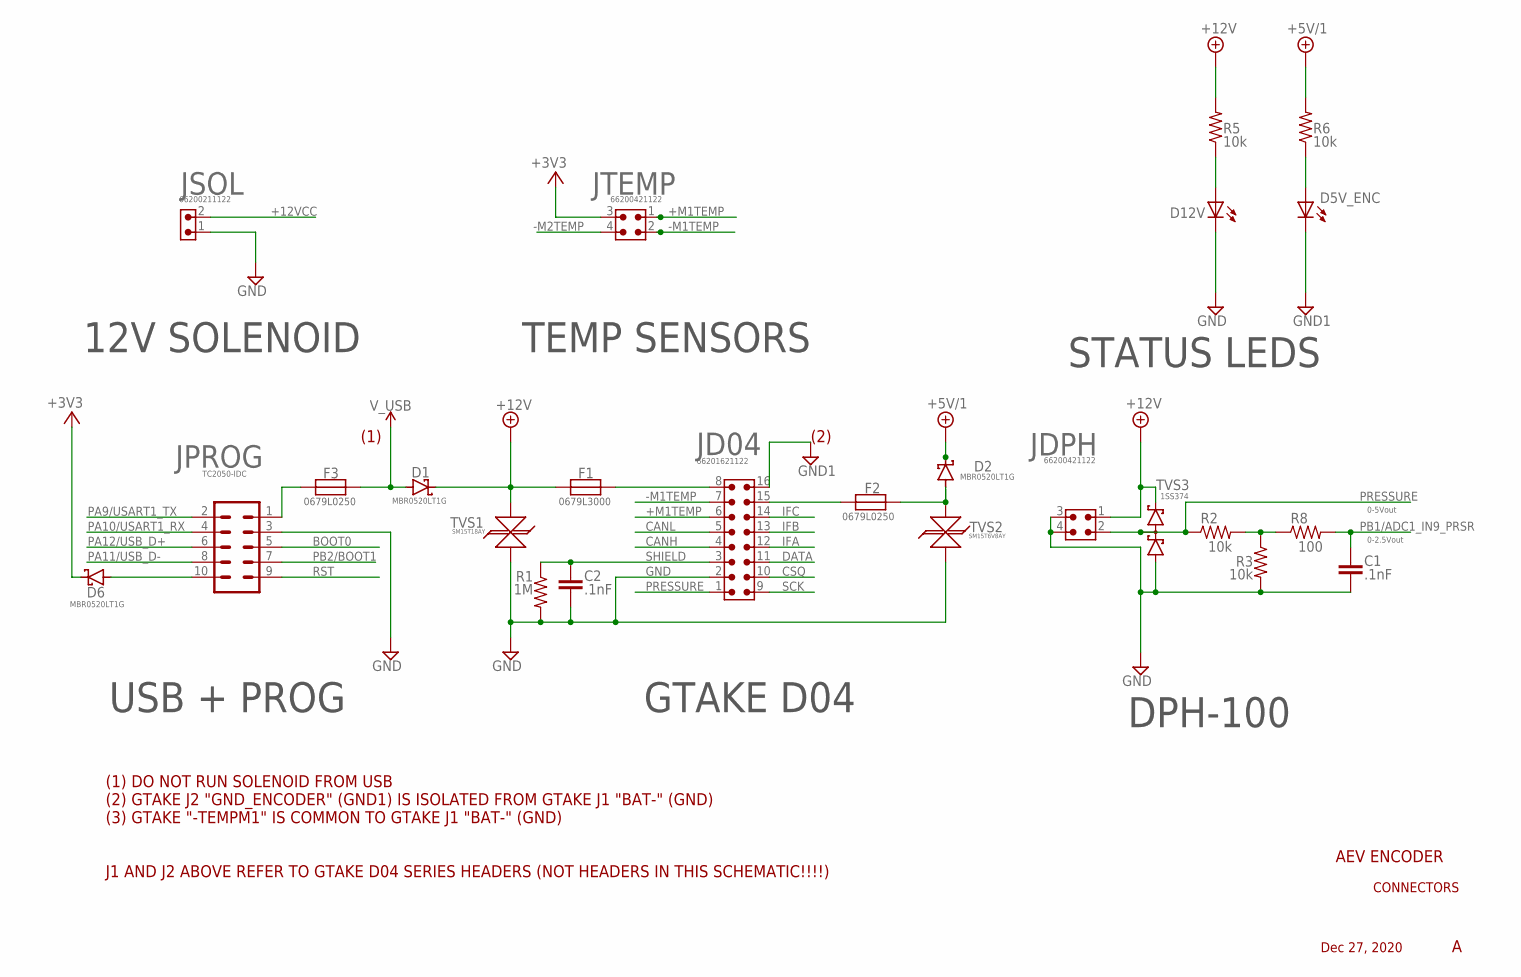
[picture p32: schematic KVR LABS - AEV ENCODER 1.01-STM32.sch, sheet 7, External Connectors]

Parts:
C1, C2: .1nF; C0603
D1, D2, D6: MBR0520LT1G; SODFL3718X115
D5V_ENC, D12V: LEDCHIPLED_0805; CHIPLED_0805
F1: 0679L3000; 2410(6125METRIC)
F2, F3: 0679L0250; 2410(6125METRIC)
JD04: 6620XX21122_66201621122; 66201621122
JDPH: 6620XX21122_66200421122; 66200421122
JPROG: TC2050-IDC
JSOL: 6620XX11122_66200211122; 66200211122
JTEMP: 6620XX21122_66200421122; 66200421122
R1: 1M; R0603
R2, R3, R5, R6: 10k; R0603
R8: 100; R0603
TVS1: SM15T18AY; SMC
TVS2: SM15T6V8AY; SMC
TVS3: BAS70-04; SOT23

Connections:
+3V3: D6.1 (C), JTEMP.3; also elsewhere on the board
+5V/1: D2.1 (C), R6.2; also elsewhere on the board
+12V: D1.1 (C), F1.P1, JDPH.1, R5.2, TVS1.P$2, TVS3.2 (C2); also elsewhere on the board
+12VCC: JSOL.2; also elsewhere on the board
+M1TEMP: JD04.6, JTEMP.1
-M1TEMP: JD04.7, JTEMP.2
-M2TEMP: JTEMP.4; also elsewhere on the board
BOOT0: JPROG.5; also elsewhere on the board
CANH: JD04.4; also elsewhere on the board
CANL: JD04.5; also elsewhere on the board
CSQ: JD04.10; also elsewhere on the board
DATA: JD04.11; also elsewhere on the board
GND: C1.2, C2.2, D12V.C, JD04.2, JDPH.3, JDPH.4, JPROG.3, JSOL.1, R1.2, R3.2, TVS1.P$1, TVS2.P$1, TVS3.1 (A1); also elsewhere on the board
GND1: D5V_ENC.C, JD04.16; also elsewhere on the board
IFA: JD04.12; also elsewhere on the board
IFB: JD04.13; also elsewhere on the board
IFC: JD04.14; also elsewhere on the board
unnamed: F2.P1, JD04.15
unnamed: D2.2 (A), F2.P2, TVS2.P$2
unnamed: F1.P2, JD04.8
unnamed: D6.2 (A), JPROG.10
unnamed: F3.P1, JPROG.1
unnamed: D12V.A, R5.1
unnamed: R2.2, R3.1, R8.1
unnamed: D5V_ENC.A, R6.1
PA9/USART1_TX: JPROG.2; also elsewhere on the board
PA10/USART1_RX: JPROG.4; also elsewhere on the board
PA11/USB_D-: JPROG.8; also elsewhere on the board
PA12/USB_D+: JPROG.6; also elsewhere on the board
PB1/ADC1_IN9_PRSR: C1.1, R8.2; also elsewhere on the board
PB2/BOOT1: JPROG.7; also elsewhere on the board
PRESSURE: JD04.1, JDPH.2, R2.1, TVS3.3 (C1A2)
RST: JPROG.9
SCK: JD04.9; also elsewhere on the board
SHIELD: C2.1, JD04.3, R1.1
V_USB: D1.2 (A), F3.P2

Notes on the sheet:
USB + PROG
0-5Vout
AEV ENCODER
Dec 27, 2020
GTAKE D04
DPH-100
TEMP SENSORS
12V SOLENOID
0-2.5Vout
STATUS LEDS
CONNECTORS
SM15T18AY
SM15T6V8AY
(1) DO NOT RUN SOLENOID FROM USB (2) GTAKE J2 "GND_ENCODER" (GND1) IS ISOLATED FROM GTAKE J1 "BAT-" (GND) (3) GTAKE "-TEMPM1" IS COMMON TO GTAKE J1 "BAT-" (GND) J1 AND J2 ABOVE REFER TO GTAKE D04 SERIES HEADERS (NOT HEADERS IN THIS SCHEMATIC!!!!)
(1)
(2)

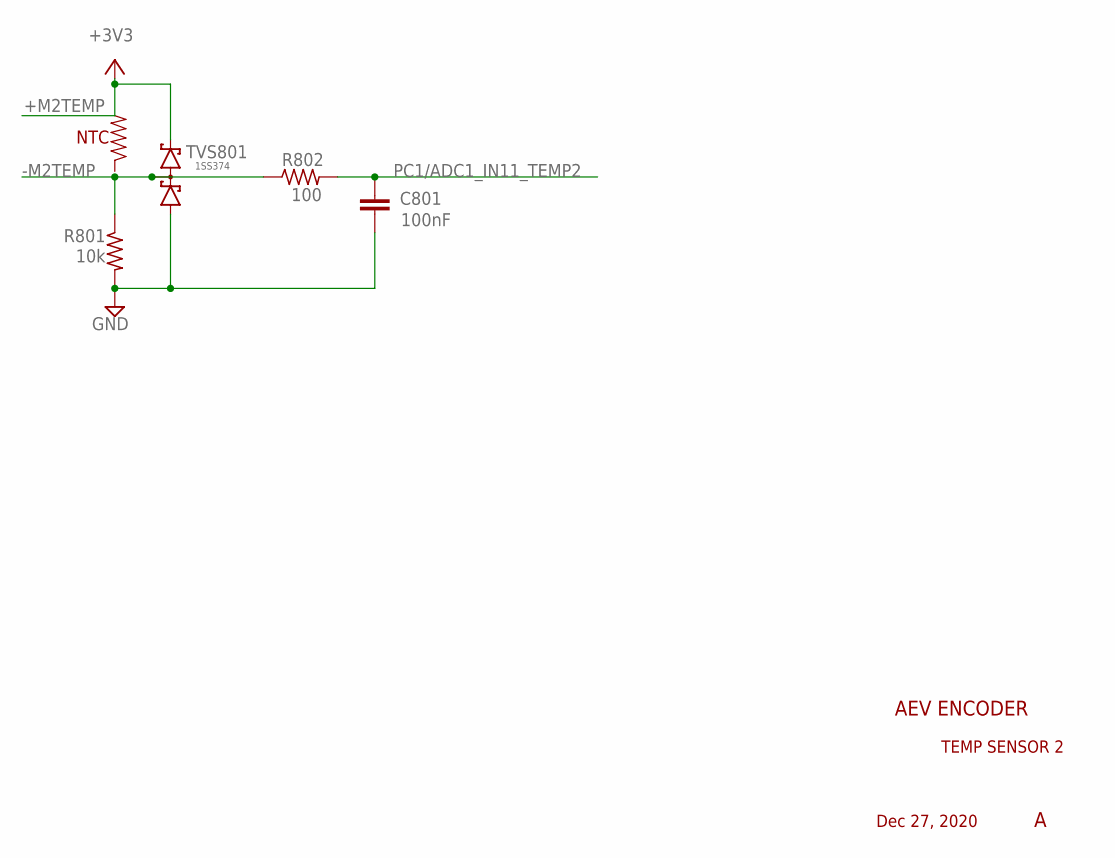
[picture p33: schematic KVR LABS - AEV ENCODER 1.01-STM32.sch, sheet 8, TEMP SENSORS]

Parts:
C801: 100nF; C0603
R801: 10k; R0603
R802: 100; R0603
TVS801: BAS70-04; SOT23

Connections:
+3V3: TVS801.2 (C2); also elsewhere on the board
-M2TEMP: R801.1, R802.1, TVS801.3 (C1A2); also elsewhere on the board
GND: C801.2, R801.2, TVS801.1 (A1); also elsewhere on the board
PC1/ADC1_IN11_TEMP2: C801.1, R802.2; also elsewhere on the board

Notes on the sheet:
NTC
+M2TEMP
AEV ENCODER
TEMP SENSOR 2
Dec 27, 2020

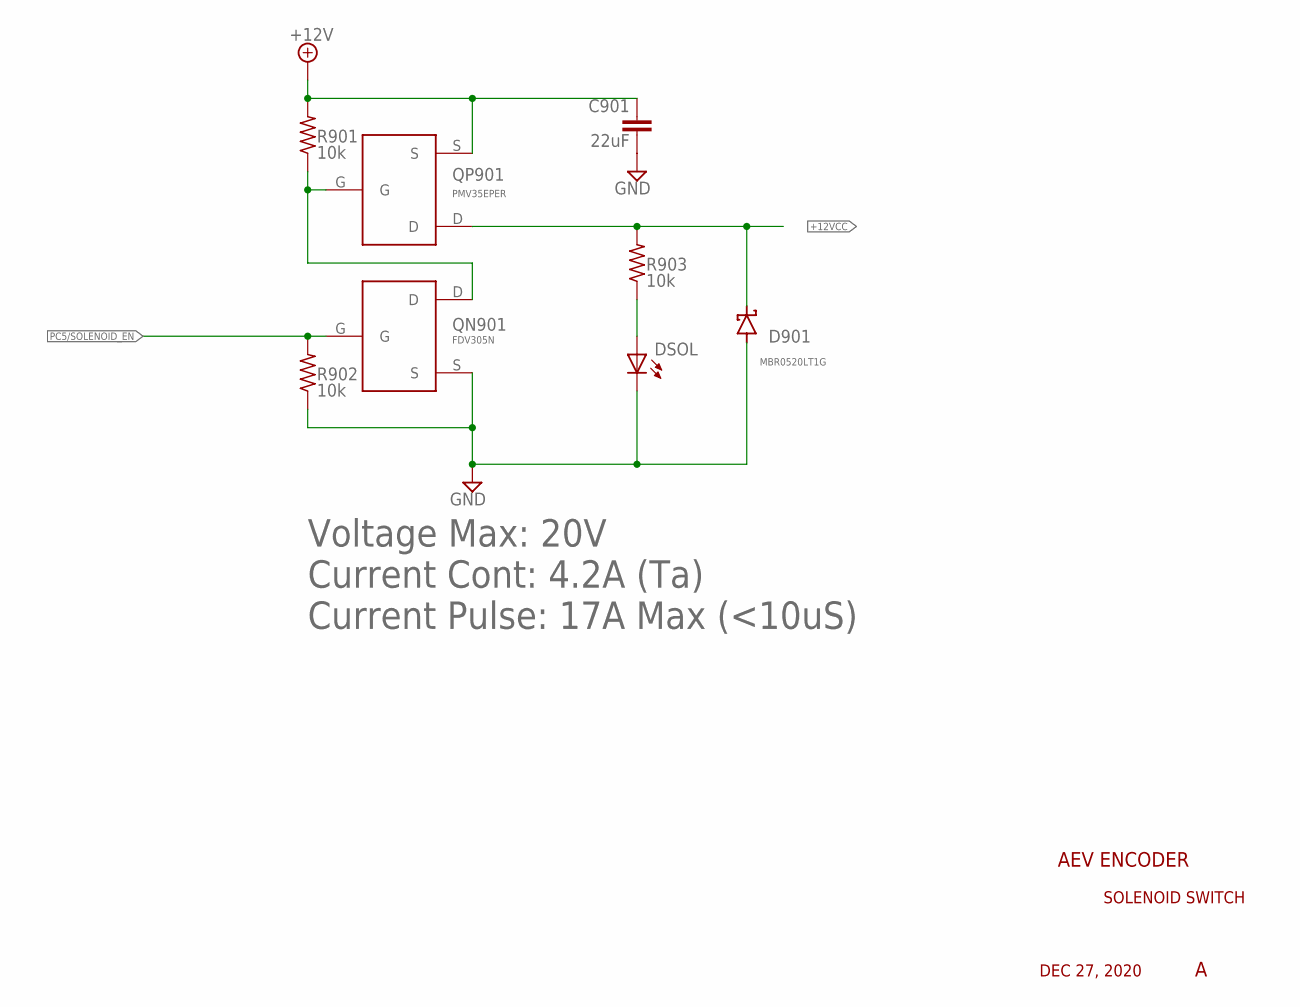
[picture p34: schematic KVR LABS - AEV ENCODER 1.01-STM32.sch, sheet 9, 12V SOLENOID LOAD SWITCH]

Parts:
C901: 22uF; C1206
D901: MBR0520LT1G; SODFL3718X115
DSOL: LEDCHIPLED_0805; CHIPLED_0805
QN901: FDV305N; SOT323-3_NFET
QP901: ZXM61P02FTA; SOT323-3_NFET
R901, R902, R903: 10k; R0603

Connections:
+12V: C901.1, QP901.S, R901.2; also elsewhere on the board
+12VCC: D901.1 (C), QP901.D, R903.2; also elsewhere on the board
GND: C901.2, D901.2 (A), DSOL.C, QN901.S, R902.1; also elsewhere on the board
unnamed: QN901.D, QP901.G, R901.1
unnamed: DSOL.A, R903.1
PC5/SOLENOID_EN: QN901.G, R902.2; also elsewhere on the board

Notes on the sheet:
Voltage Max: 20V Current Cont: 4.2A (Ta) Current Pulse: 17A Max (<10uS)
AEV ENCODER
SOLENOID SWITCH
DEC 27, 2020
QP901
QN901

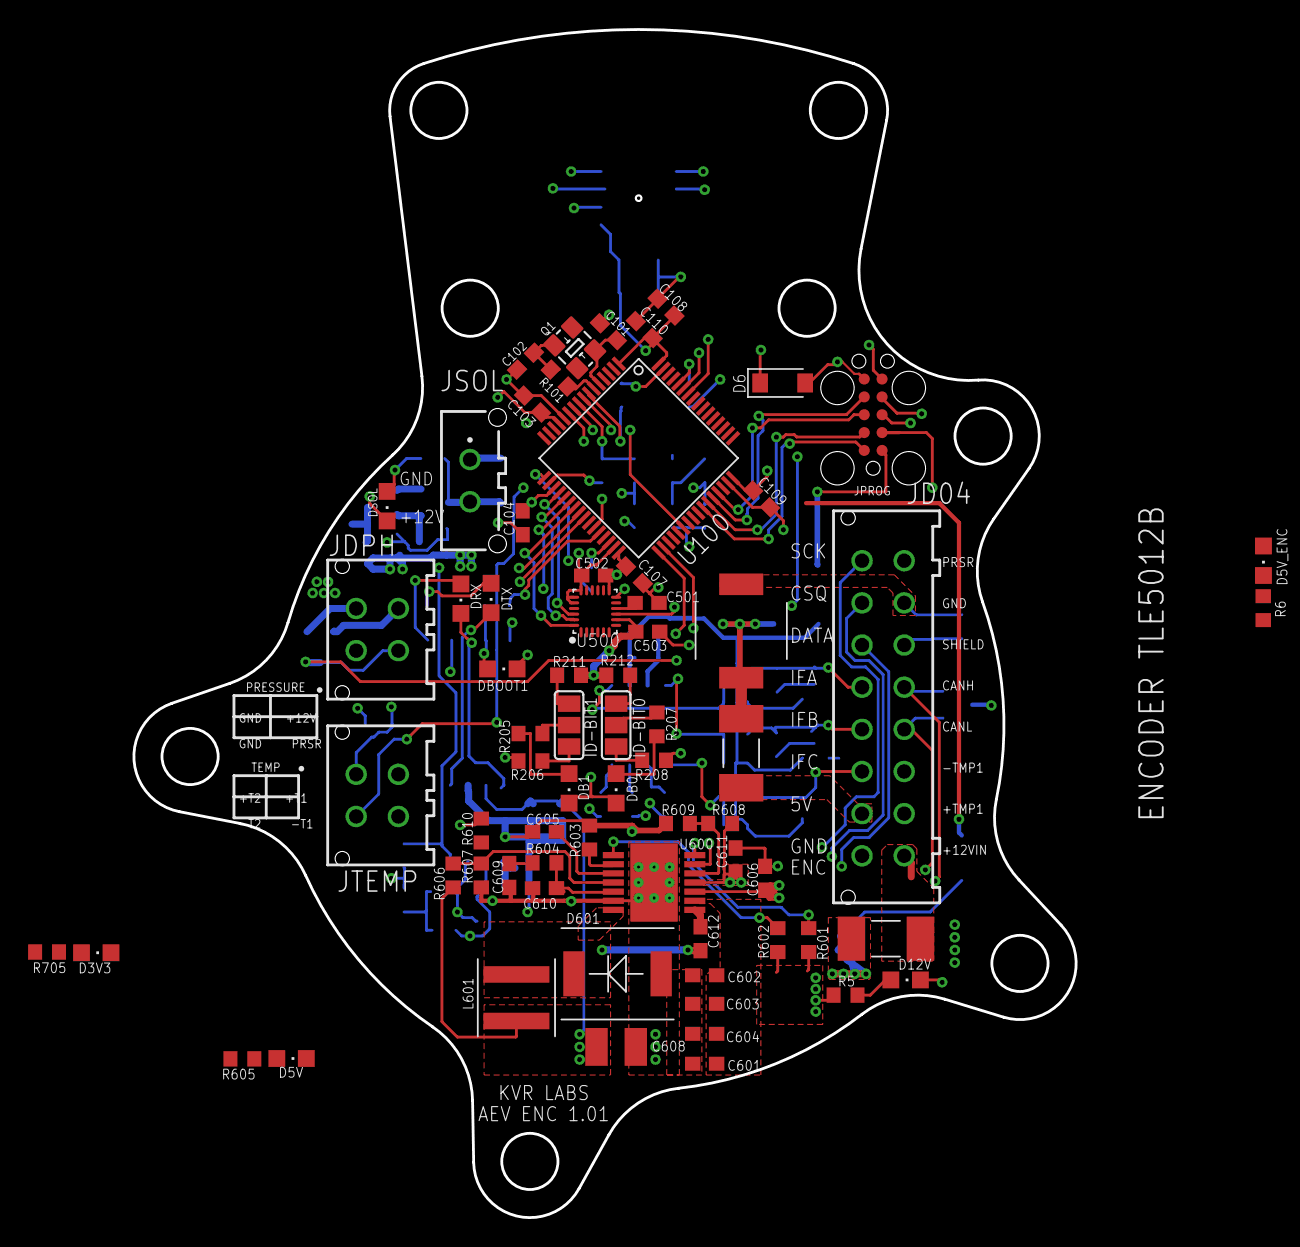
[picture p35: board KVR LABS - AEV ENCODER 1.01-STM32.brd from above]

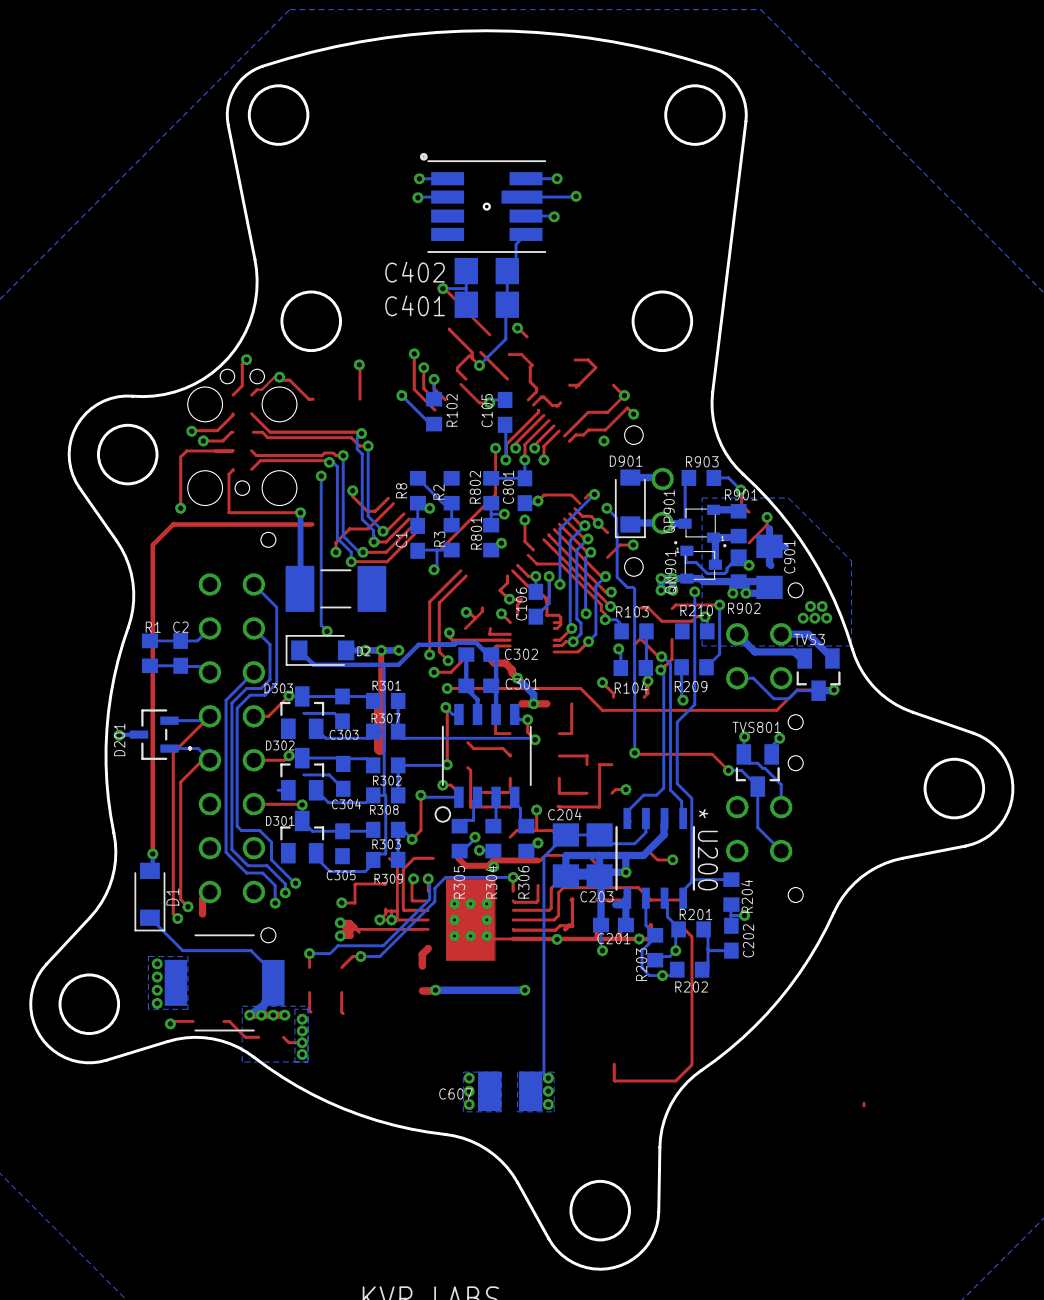
[picture p36: board KVR LABS - AEV ENCODER 1.01-STM32.brd from below]

Board: 4 copper layers, 67.1 x 84.6 mm, 130 parts (61 on the bottom side), 89 nets.
