aleckorver/KVR-ENCDR/SAMD21G18/Standard Board/EAGLE FILES/On Axis Encoder.brd

## EAGLE design SAMD21G18/Standard Board/EAGLE FILES/On Axis Encoder.brd (2020-12-15)

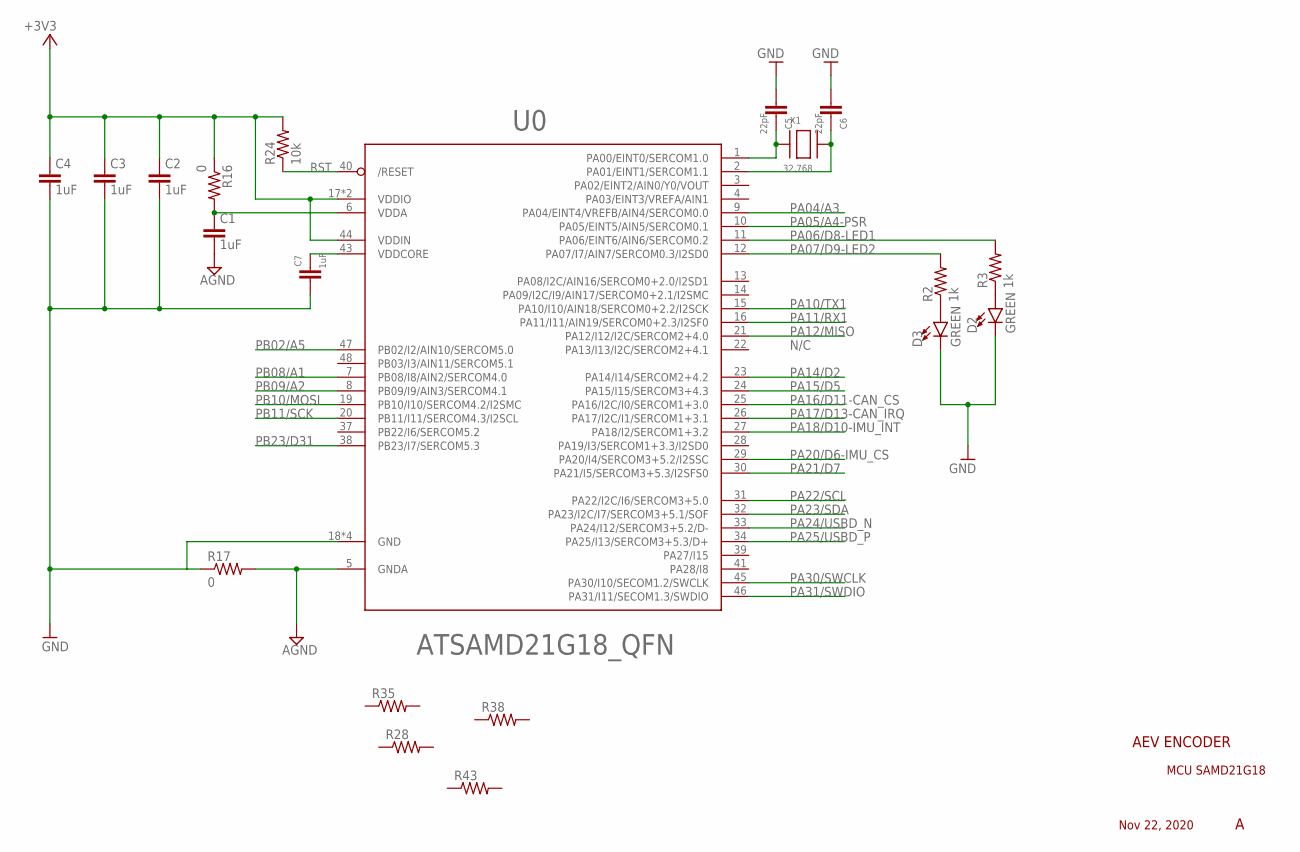
[picture p37: schematic On Axis Encoder.sch, sheet 1, ATSAMD21G18]

Parts:
C1, C2, C3, C4, C7: 1uF; C0805
C5, C6: 22pF; C0805
D2, D3: GREEN; LED-0603
R2, R3: 1k; R0603
R16, R17: 0; R0805
R24: 10k; R0805
R28: R-US_R0603; R0603
R35: R-US_R0402; R0402
R38: R-US_R0201; R0201
R43: R-US_R0805; R0805
U0: ATSAMD21G18_QFN; MICROBUILDER_TQFN48_7MM
X1: 32.768; XTAL3215

Connections:
+3V3: C2.1, C3.1, C4.1, R16.1, R24.2, U0.17 (VDDIO), U0.36 (VDDIO), U0.44 (VDDIN); also elsewhere on the board
AGND: C1.2, R17.2, U0.5 (GNDA); also elsewhere on the board
GND: C2.2, C3.2, C4.2, C5.2, C6.2, C7.2, D2.C, D3.C, R17.1, U0.18 (GND), U0.35 (GND), U0.42 (GND), U0.THERMAL (GND); also elsewhere on the board
unnamed: D2.A, R3.1
unnamed: D3.A, R2.1
unnamed: C5.1, U0.1 (PA00/EINT0/SERCOM1.0), X1.P$1
unnamed: C6.1, U0.2 (PA01/EINT1/SERCOM1.1), X1.P$2
unnamed: C1.1, R16.2, U0.6 (VDDA)
PA04/A3: U0.9 (PA04/EINT4/VREFB/AIN4/SERCOM0.0)
PA05/A4-PSR: U0.10 (PA05/EINT5/AIN5/SERCOM0.1); also elsewhere on the board
PA06/D8-LED1: R3.2, U0.11 (PA06/EINT6/AIN6/SERCOM0.2)
PA07/D9-LED2: R2.2, U0.12 (PA07/I7/AIN7/SERCOM0.3/I2SD0)
PA10/TX1: U0.15 (PA10/I10/AIN18/SERCOM0+2.2/I2SCK)
PA11/RX1: U0.16 (PA11/I11/AIN19/SERCOM0+2.3/I2SF0)
PA12/MISO: U0.21 (PA12/I12/I2C/SERCOM2+4.0); also elsewhere on the board
PA14/D2: U0.23 (PA14/I14/SERCOM2+4.2)
PA15/D5: U0.24 (PA15/I15/SERCOM3+4.3)
PA16/D11-CAN_CS: U0.25 (PA16/I2C/I0/SERCOM1+3.0); also elsewhere on the board
PA17/D13-CAN_IRQ: U0.26 (PA17/I2C/I1/SERCOM1+3.1); also elsewhere on the board
PA18/D10-IMU_INT: U0.27 (PA18/I2/SERCOM1+3.2); also elsewhere on the board
PA20/D6-IMU_CS: U0.29 (PA20/I4/SERCOM3+5.2/I2SSC); also elsewhere on the board
PA21/D7: U0.30 (PA21/I5/SERCOM3+5.3/I2SFS0)
PA22/SCL: U0.31 (PA22/I2C/I6/SERCOM3+5.0); also elsewhere on the board
PA23/SDA: U0.32 (PA23/I2C/I7/SERCOM3+5.1/SOF); also elsewhere on the board
PA24/USBD_N: U0.33 (PA24/I12/SERCOM3+5.2/D-); also elsewhere on the board
PA25/USBD_P: U0.34 (PA25/I13/SERCOM3+5.3/D+); also elsewhere on the board
PA30/SWCLK: U0.45 (PA30/I10/SECOM1.2/SWCLK); also elsewhere on the board
PA31/SWDIO: U0.46 (PA31/I11/SECOM1.3/SWDIO); also elsewhere on the board
PB02/A5: U0.47 (PB02/I2/AIN10/SERCOM5.0)
PB08/A1: U0.7 (PB08/I8/AIN2/SERCOM4.0)
PB09/A2: U0.8 (PB09/I9/AIN3/SERCOM4.1)
PB10/MOSI: U0.19 (PB10/I10/SERCOM4.2/I2SMC); also elsewhere on the board
PB11/SCK: U0.20 (PB11/I11/SERCOM4.3/I2SCL); also elsewhere on the board
PB23/D31: U0.38 (PB23/I7/SERCOM5.3)
RST: R24.1, U0.40 (/RESET); also elsewhere on the board
VDDCORE2: C7.1, U0.43 (VDDCORE)

Notes on the sheet:
N/C
AEV ENCODER
MCU SAMD21G18
Nov 22, 2020

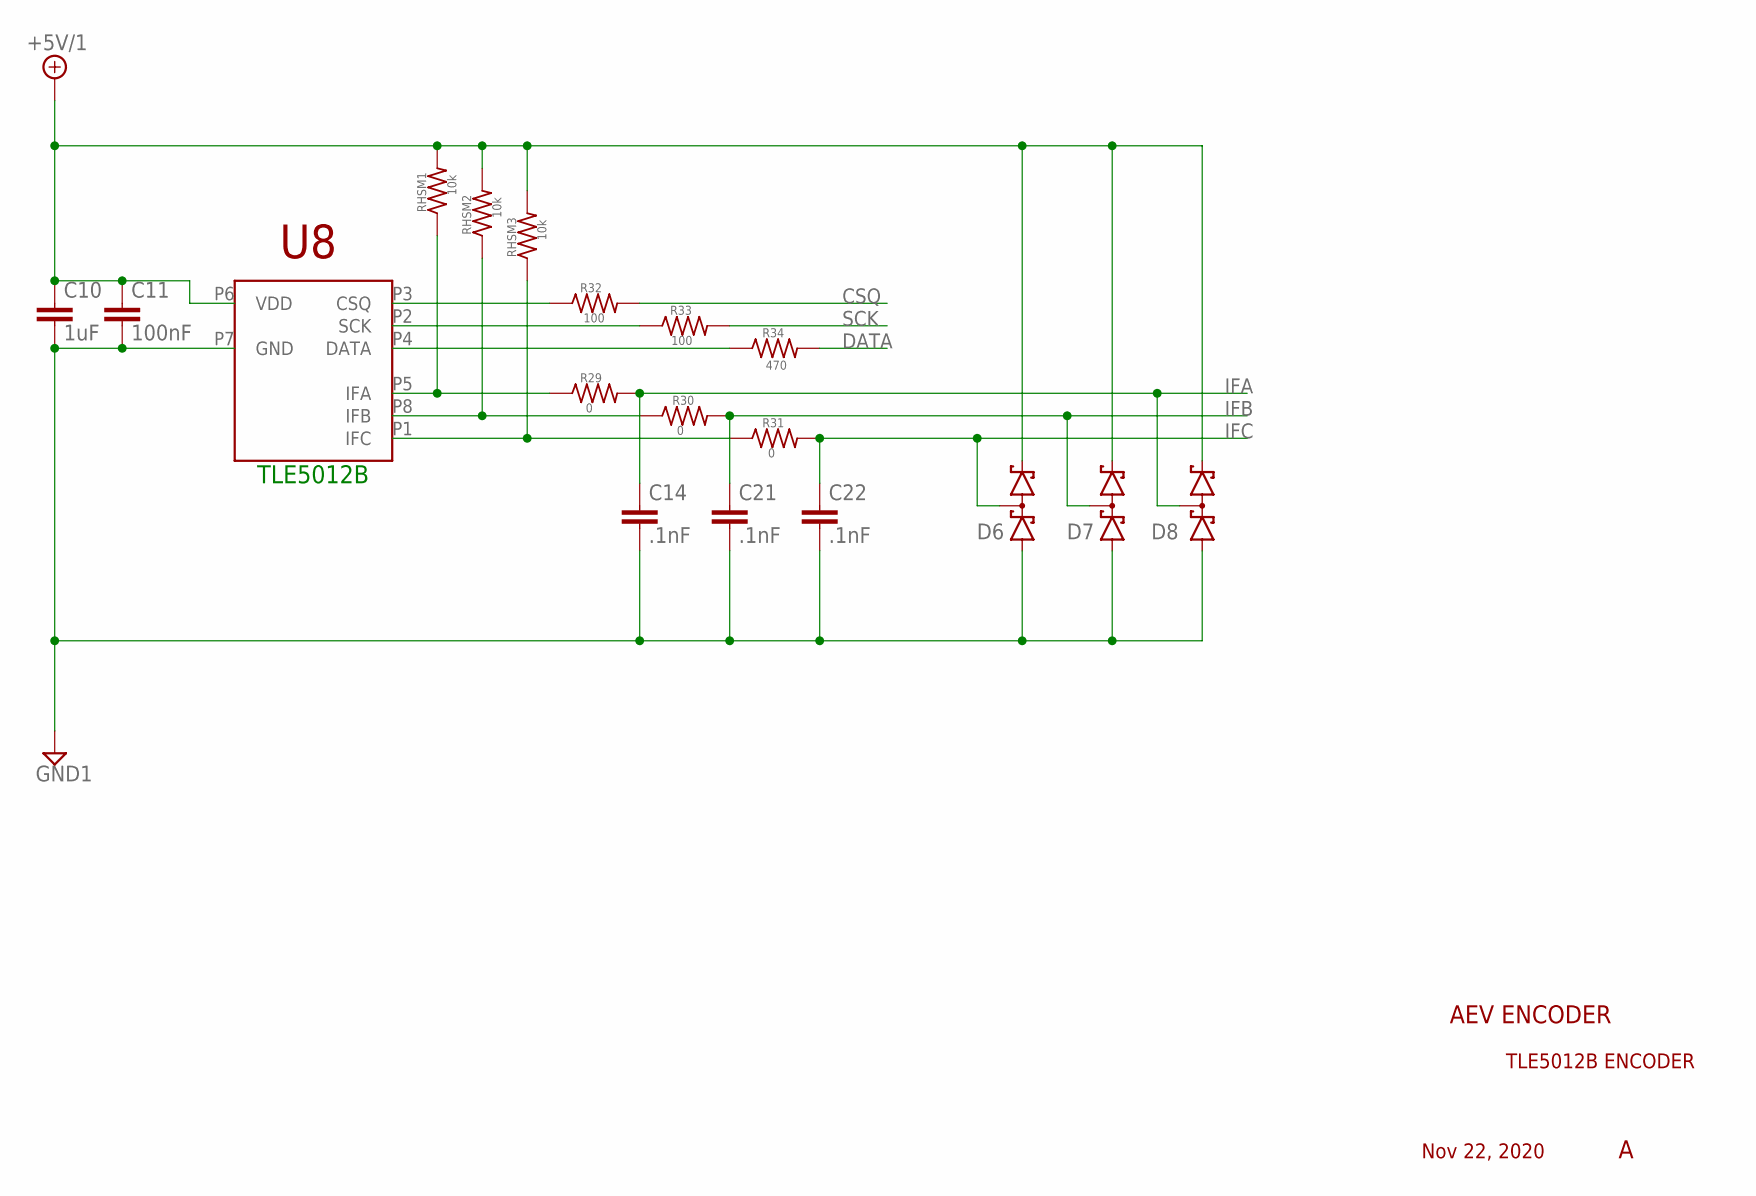
[picture p38: schematic On Axis Encoder.sch, sheet 2, ABSOLUTE ENCODER]

Parts:
C10: 1uF; C0805
C11: 100nF; C0805
C14, C21, C22: .1nF; C0805
D6, D7, D8: BAS70-04; SOT23
R29, R30, R31: 0; R0805
R32, R33: 100; R0805
R34: 470; R0805
RHSM1, RHSM2, RHSM3: 10k; R0805
U8: TLE5012B; PG-DSO-8

Connections:
+5V/1: C10.1, C11.1, D6.2 (C2), D7.2 (C2), D8.2 (C2), RHSM1.2, RHSM2.2, RHSM3.2, U8.P6 (VDD); also elsewhere on the board
CSQ: R32.2; also elsewhere on the board
DATA: R34.2; also elsewhere on the board
GND1: C10.2, C11.2, C14.2, C21.2, C22.2, D6.1 (A1), D7.1 (A1), D8.1 (A1), U8.P7 (GND); also elsewhere on the board
IFA: C14.1, D8.3 (C1A2), R29.2; also elsewhere on the board
IFB: C21.1, D7.3 (C1A2), R30.2; also elsewhere on the board
IFC: C22.1, D6.3 (C1A2), R31.2; also elsewhere on the board
unnamed: R32.1, U8.P3 (CSQ)
unnamed: R33.1, U8.P2 (SCK)
unnamed: R34.1, U8.P4 (DATA)
unnamed: R29.1, RHSM1.1, U8.P5 (IFA)
unnamed: R30.1, RHSM2.1, U8.P8 (IFB)
unnamed: R31.1, RHSM3.1, U8.P1 (IFC)
SCK: R33.2; also elsewhere on the board

Notes on the sheet:
TLE5012B
AEV ENCODER
TLE5012B ENCODER
Nov 22, 2020

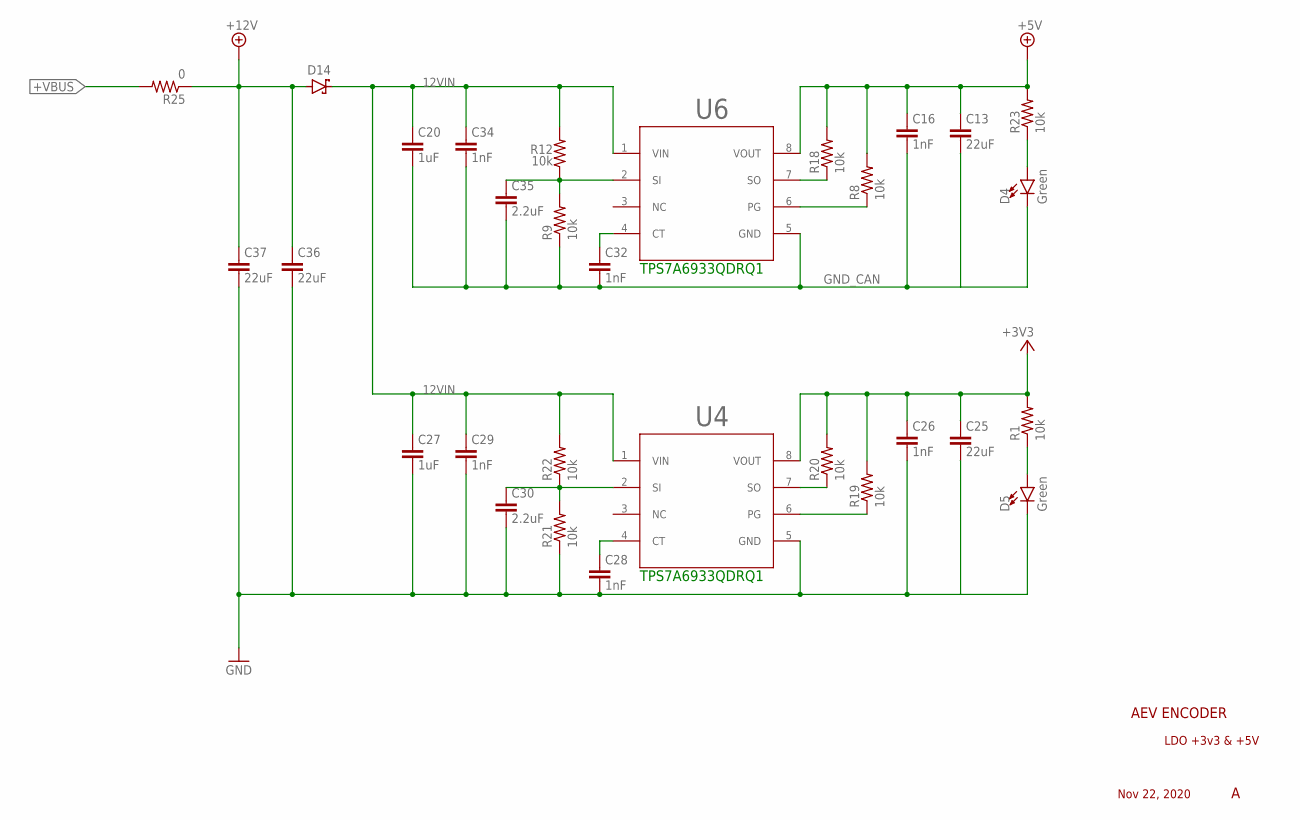
[picture p39: schematic On Axis Encoder.sch, sheet 3, Low Dropout Regulator 3v3]

Parts:
C13, C25: 22uF; C0805
C16, C26, C28, C29, C32, C34: 1nF; C0805
C20, C27: 1uF; C0805
C30, C35: 2.2uF; C0805
C36, C37: 22uF; C1206
D4, D5: Green; LED-1206-BOTTOM
D14: MBR0520LT1G; SODFL3718X115
R1, R8, R9, R12, R18, R19, R20, R21, R22, R23: 10k; R0805
R25: 0; R0805
U4, U6: Value; D0008A_N

Connections:
12VIN: C20.1, C27.1, C29.1, C34.1, D14.1 (C), R12.2, R22.2, U4.1 (VIN), U6.1 (VIN)
+3V3: C25.1, C26.1, R1.2, R19.2, R20.2, U4.8 (VOUT); also elsewhere on the board
+5V: C13.1, C16.1, R8.2, R18.2, R23.2, U6.8 (VOUT); also elsewhere on the board
+12V: C36.1, C37.1, D14.2 (A), R25.1; also elsewhere on the board
+VBUS: R25.2; also elsewhere on the board
GND: C25.2, C26.2, C27.2, C28.2, C29.2, C30.2, C36.2, C37.2, D5.C, R21.1, U4.5 (GND); also elsewhere on the board
GND_CAN: C13.2, C16.2, C20.2, C32.2, C34.2, C35.2, D4.C, R9.1, U6.5 (GND); also elsewhere on the board
unnamed: D5.A, R1.1
unnamed: C35.1, R9.2, R12.1, U6.2 (SI)
unnamed: C30.1, R21.2, R22.1, U4.2 (SI)
unnamed: R19.1, U4.6 (PG)
unnamed: R20.1, U4.7 (SO)
unnamed: C28.1, U4.4 (CT)
unnamed: R8.1, U6.6 (PG)
unnamed: R18.1, U6.7 (SO)
unnamed: C32.1, U6.4 (CT)
unnamed: D4.A, R23.1

Notes on the sheet:
TPS7A6933QDRQ1
AEV ENCODER
LDO +3v3 & +5V
Nov 22, 2020

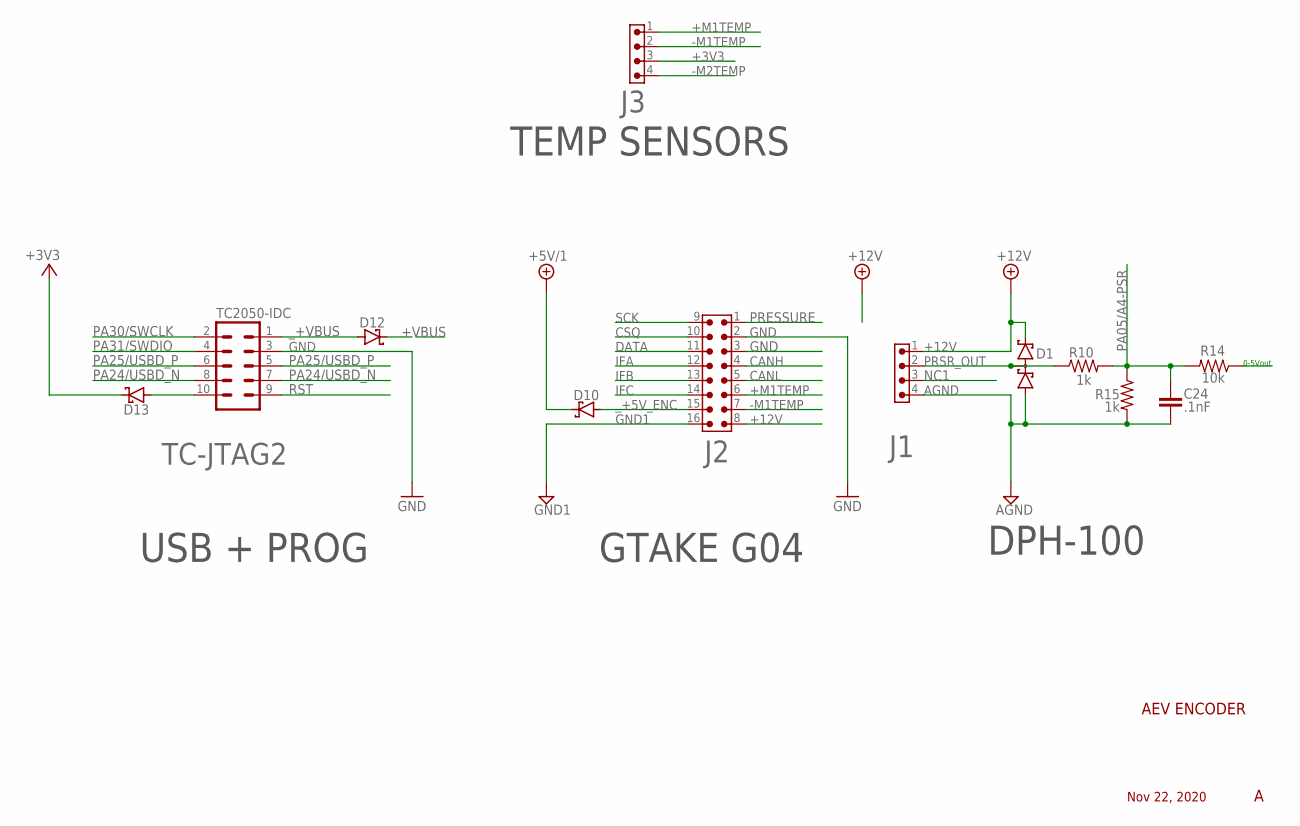
[picture p40: schematic On Axis Encoder.sch, sheet 4, Connectors]

Parts:
C24: .1nF; C0805
D1: BAS70-04; SOT23
D10, D12, D13: MBR0520LT1G; SODFL3718X115
J1, J3: 6620XX11122_66200411122; 66200411122
J2: 6620XX21122_66201621122; 66201621122
R10, R15: 1k; R0805
R14: 10k; R0805
TC-JTAG2: TC2050-IDC

Connections:
+3V3: D13.1 (C), J3.3; also elsewhere on the board
+5V/1: D10.1 (C); also elsewhere on the board
+12V: D1.2 (C2), J1.1, J2.8; also elsewhere on the board
+M1TEMP: J2.6, J3.1
+VBUS: D12.1 (C); also elsewhere on the board
-M1TEMP: J2.7, J3.2
-M2TEMP: J3.4; also elsewhere on the board
AGND: C24.2, D1.1 (A1), J1.4, R15.2; also elsewhere on the board
CANH: J2.4; also elsewhere on the board
CANL: J2.5; also elsewhere on the board
CSQ: J2.10; also elsewhere on the board
DATA: J2.11; also elsewhere on the board
GND: J2.2, J2.3, TC-JTAG2.3; also elsewhere on the board
GND1: J2.16; also elsewhere on the board
IFA: J2.12; also elsewhere on the board
IFB: J2.13; also elsewhere on the board
IFC: J2.14; also elsewhere on the board
unnamed: D13.2 (A), TC-JTAG2.10
NC1: J1.3
PA05/A4-PSR: C24.1, R10.2, R14.2, R15.1; also elsewhere on the board
PA24/USBD_N: TC-JTAG2.7, TC-JTAG2.8; also elsewhere on the board
PA25/USBD_P: TC-JTAG2.5, TC-JTAG2.6; also elsewhere on the board
PA30/SWCLK: TC-JTAG2.2; also elsewhere on the board
PA31/SWDIO: TC-JTAG2.4; also elsewhere on the board
PRESSURE: J2.1, R14.1
PRSR_OUT: D1.3 (C1A2), J1.2, R10.1
RST: TC-JTAG2.9; also elsewhere on the board
SCK: J2.9; also elsewhere on the board
_+5V_ENC: D10.2 (A), J2.15
_+VBUS: D12.2 (A), TC-JTAG2.1

Notes on the sheet:
USB + PROG
0-5Vout
AEV ENCODER
Nov 22, 2020
GTAKE G04
DPH-100
TEMP SENSORS

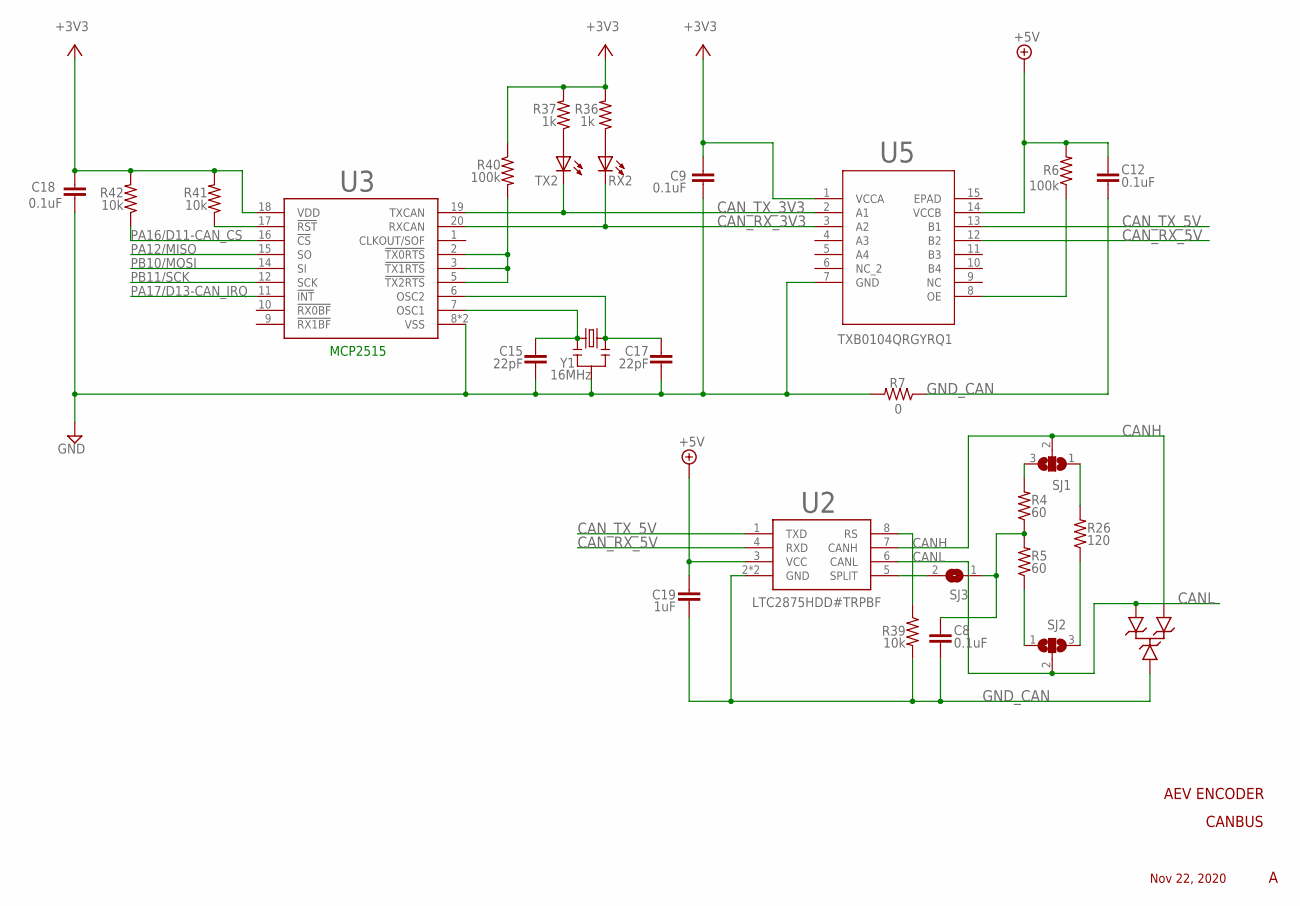
[picture p41: schematic On Axis Encoder.sch, sheet 5, CANbus]

Parts:
C8, C9, C12, C18: 0.1uF; C0805
C15, C17: 22pF; C0805
C19: 1uF; C0805
R4, R5: 60; R0805
R6, R40: 100k; R0805
R7: 0; R0805
R26: 120; R0805
R36, R37: 1k; R0805
R39, R41, R42: 10k; R0805
RX2: LEDCHIPLED_0805; CHIPLED_0805
SJ1, SJ2: SJ2W; SJ_2
SJ3: SJ
TX2: LEDCHIPLED_0805; CHIPLED_0805
U2: LTC2875HDD#TRPBF; SON50P300X300X80-9T165X238N
U3: MCP2515-E/ML; QFN50P400X400X100-21T270N
U5: TXB0104QRGYRQ1; RGY14_2P05X2P05
U$2: μCLAMP2492SQ; SOT-23_3L_ONS
Y1: 16MHz; RESONATOR-SMD

Connections:
+3V3: C9.1, C18.1, R36.2, R37.2, R40.1, R41.2, R42.2, U3.18 (VDD), U5.1 (VCCA); also elsewhere on the board
+5V: C12.1, C19.1, R6.2, U2.3 (VCC), U5.14 (VCCB); also elsewhere on the board
CANH: SJ1.2, U2.7 (CANH), U$2.2; also elsewhere on the board
CANL: SJ2.2, U2.6 (CANL), U$2.1; also elsewhere on the board
CAN_RX_3V3: RX2.C, U3.20 (RXCAN), U5.3 (A2)
CAN_RX_5V: U2.4 (RXD), U5.12 (B2)
CAN_TX_3V3: TX2.C, U3.19 (TXCAN), U5.2 (A1)
CAN_TX_5V: U2.1 (TXD), U5.13 (B1)
GND: C9.2, C15.2, C17.2, C18.2, R7.2, U3.8 (VSS), U3.21 (VSS), U5.7 (GND), Y1.2; also elsewhere on the board
GND_CAN: C8.2, C12.2, C19.2, R7.1, R39.2, U2.2 (GND), U2.9 (GND), U$2.3; also elsewhere on the board
unnamed: R6.1, U5.8 (OE)
unnamed: R39.1, U2.8 (RS)
unnamed: SJ3.2, U2.5 (SPLIT)
unnamed: R36.1, RX2.A
unnamed: R37.1, TX2.A
unnamed: R41.1, U3.17 (!RST)
unnamed: R40.2, U3.2 (!TX0RTS), U3.3 (!TX1RTS), U3.5 (!TX2RTS)
unnamed: C17.1, U3.6 (OSC2), Y1.3
unnamed: C15.1, U3.7 (OSC1), Y1.1
PA12/MISO: U3.15 (SO); also elsewhere on the board
PA16/D11-CAN_CS: R42.1, U3.16 (!CS); also elsewhere on the board
PA17/D13-CAN_IRQ: U3.11 (!INT); also elsewhere on the board
PB10/MOSI: U3.14 (SI); also elsewhere on the board
PB11/SCK: U3.12 (SCK); also elsewhere on the board
RSH: R4.2, SJ1.3
RSL: R5.1, SJ2.1
RTH: R26.2, SJ1.1
RTL: R26.1, SJ2.3
SPLIT: C8.1, R4.1, R5.2, SJ3.1

Notes on the sheet:
MCP2515
CANBUS
AEV ENCODER
Nov 22, 2020

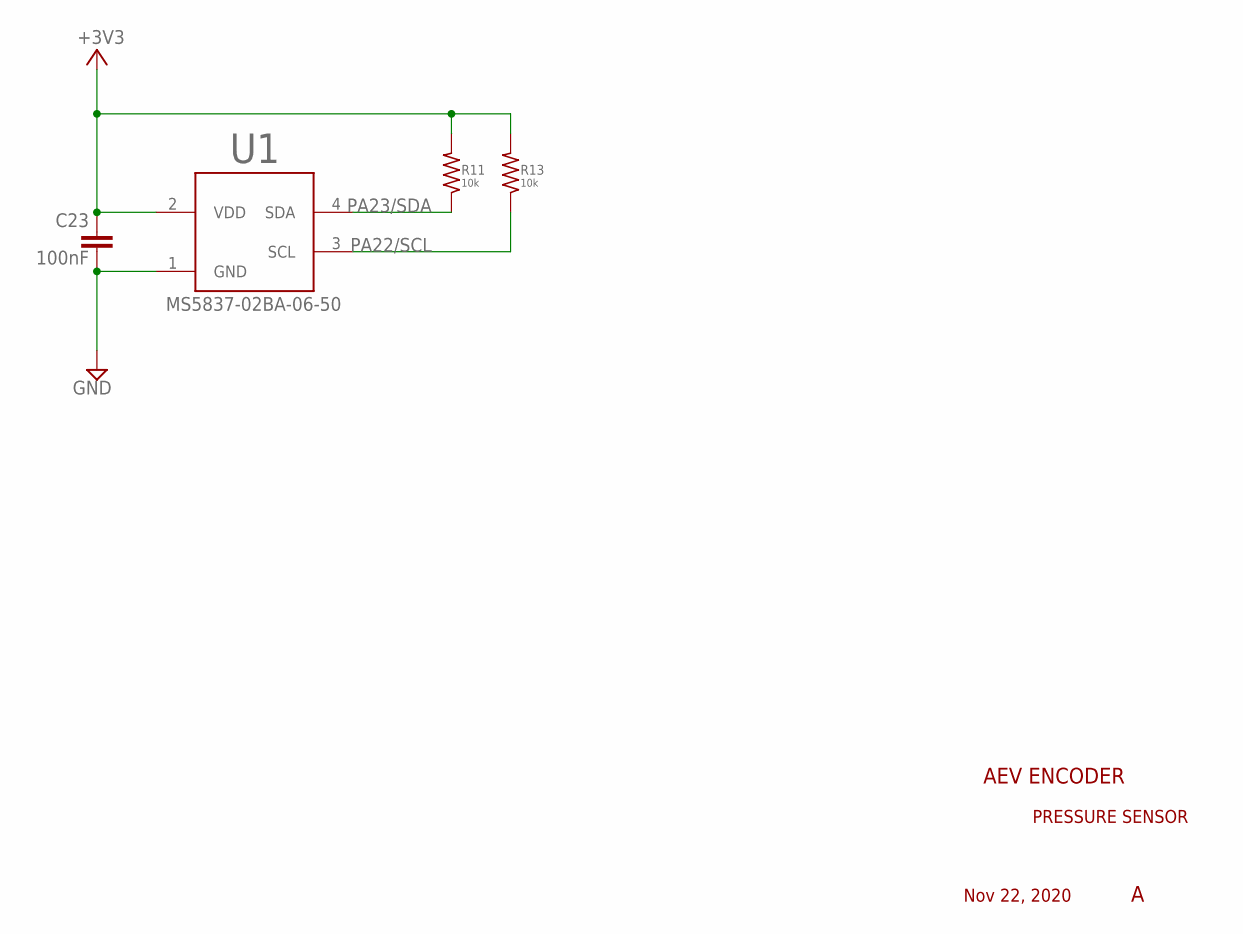
[picture p42: schematic On Axis Encoder.sch, sheet 6, PRESSURE SENSOR]

Parts:
C23: 100nF; C0603
R11, R13: 10k; R0603
U1: MS5837-02BA-06-50; DFN330X330X275-4N

Connections:
+3V3: C23.1, R11.2, R13.2, U1.2 (VDD); also elsewhere on the board
GND: C23.2, U1.1 (GND); also elsewhere on the board
PA22/SCL: R13.1, U1.3 (SCL); also elsewhere on the board
PA23/SDA: R11.1, U1.4 (SDA); also elsewhere on the board

Notes on the sheet:
AEV ENCODER
PRESSURE SENSOR
Nov 22, 2020

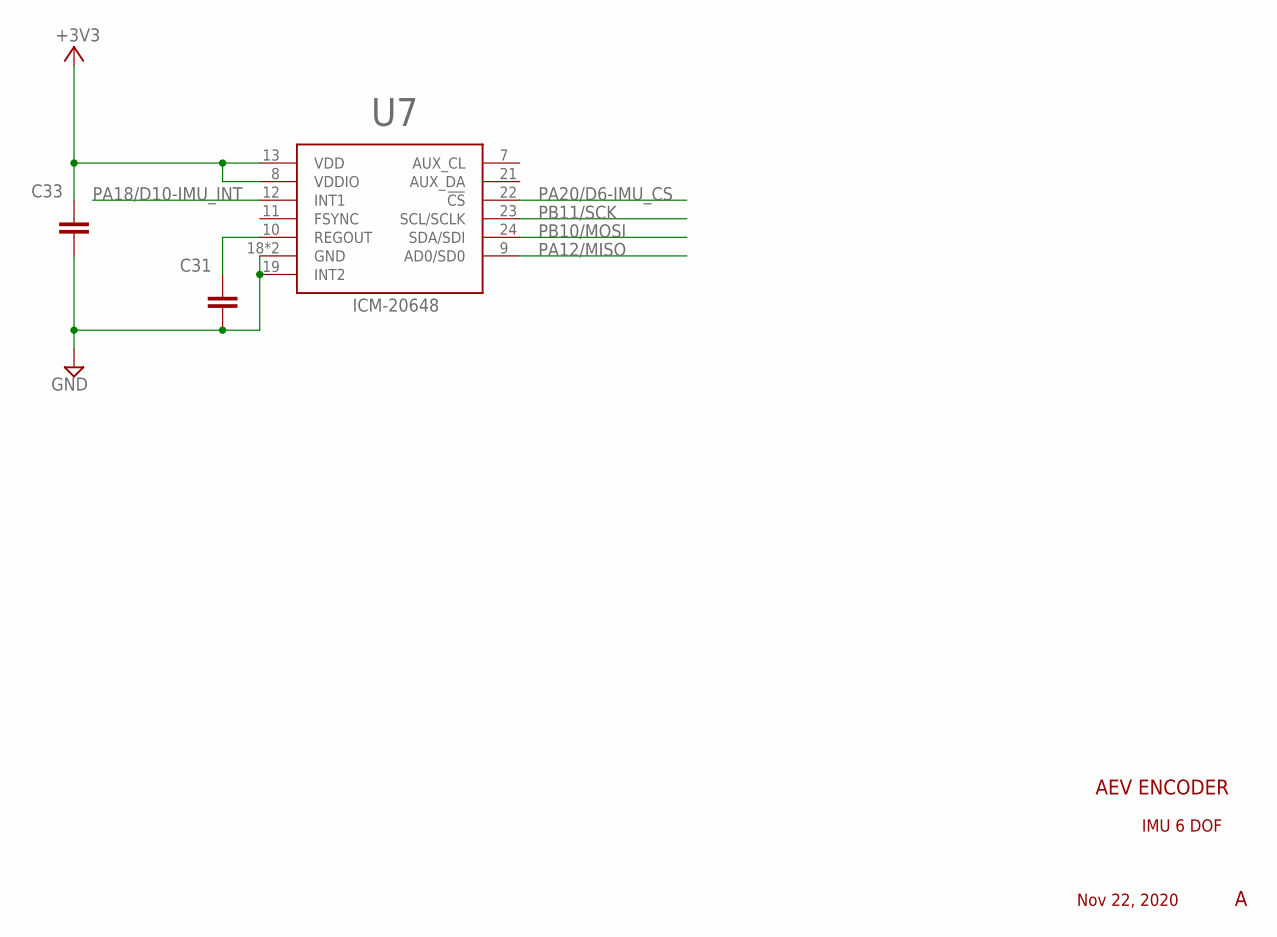
[picture p43: schematic On Axis Encoder.sch, sheet 7, IMU - ICM20648]

Parts:
C31, C33: 0.1uF; 0603
U7: ICM-20648

Connections:
+3V3: C33.P$1 (1), U7.8 (VDDIO), U7.13 (VDD); also elsewhere on the board
GND: C31.P$2 (2), C33.P$2 (2), U7.18 (GND), U7.19 (INT2), U7.20 (GND); also elsewhere on the board
PA12/MISO: U7.9 (AD0/SD0); also elsewhere on the board
PA18/D10-IMU_INT: U7.12 (INT1); also elsewhere on the board
PA20/D6-IMU_CS: U7.22 (!CS); also elsewhere on the board
PB10/MOSI: U7.24 (SDA/SDI); also elsewhere on the board
PB11/SCK: U7.23 (SCL/SCLK); also elsewhere on the board
REGOUT2: C31.P$1 (1), U7.10 (REGOUT)

Notes on the sheet:
AEV ENCODER
IMU 6 DOF
Nov 22, 2020

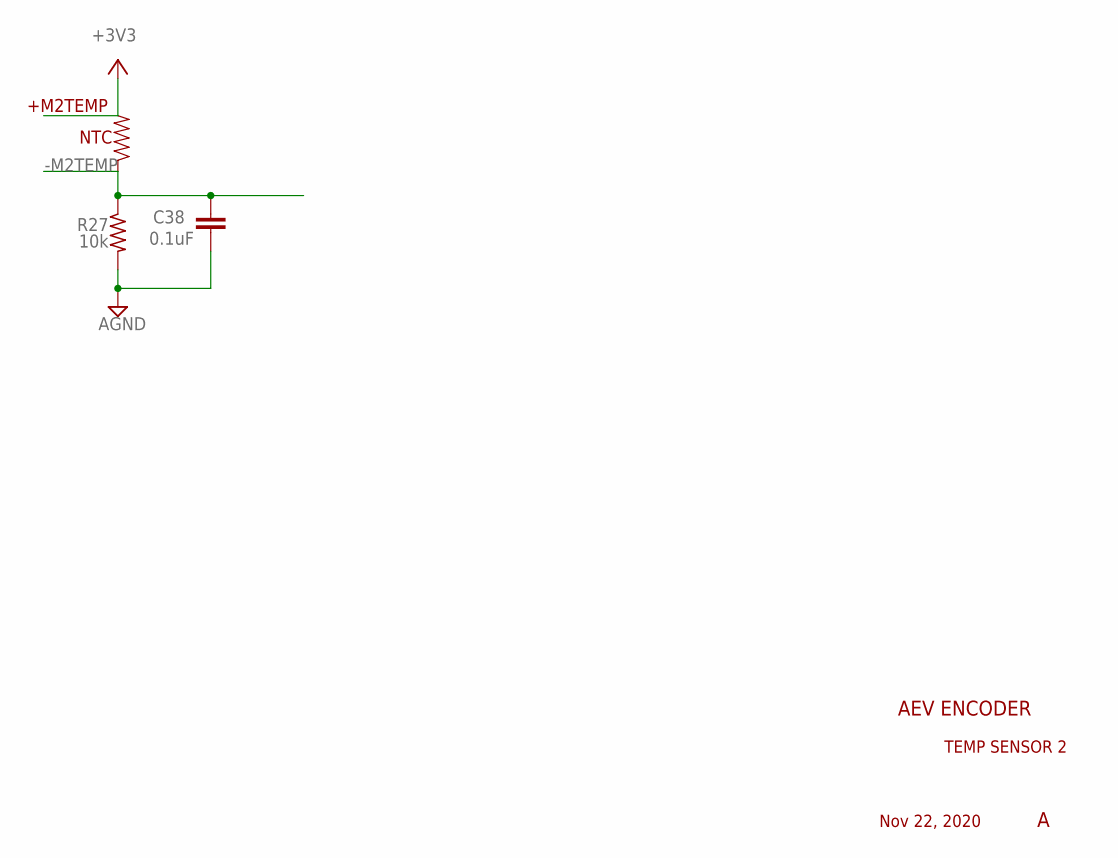
[picture p44: schematic On Axis Encoder.sch, sheet 8, TEMP SENSORS]

Parts:
C38: 0.1uF; C0805
R27: 10k; R0805

Connections:
-M2TEMP: C38.1, R27.1; also elsewhere on the board
AGND: C38.2, R27.2; also elsewhere on the board

Notes on the sheet:
NTC
+M2TEMP
AEV ENCODER
TEMP SENSOR 2
Nov 22, 2020

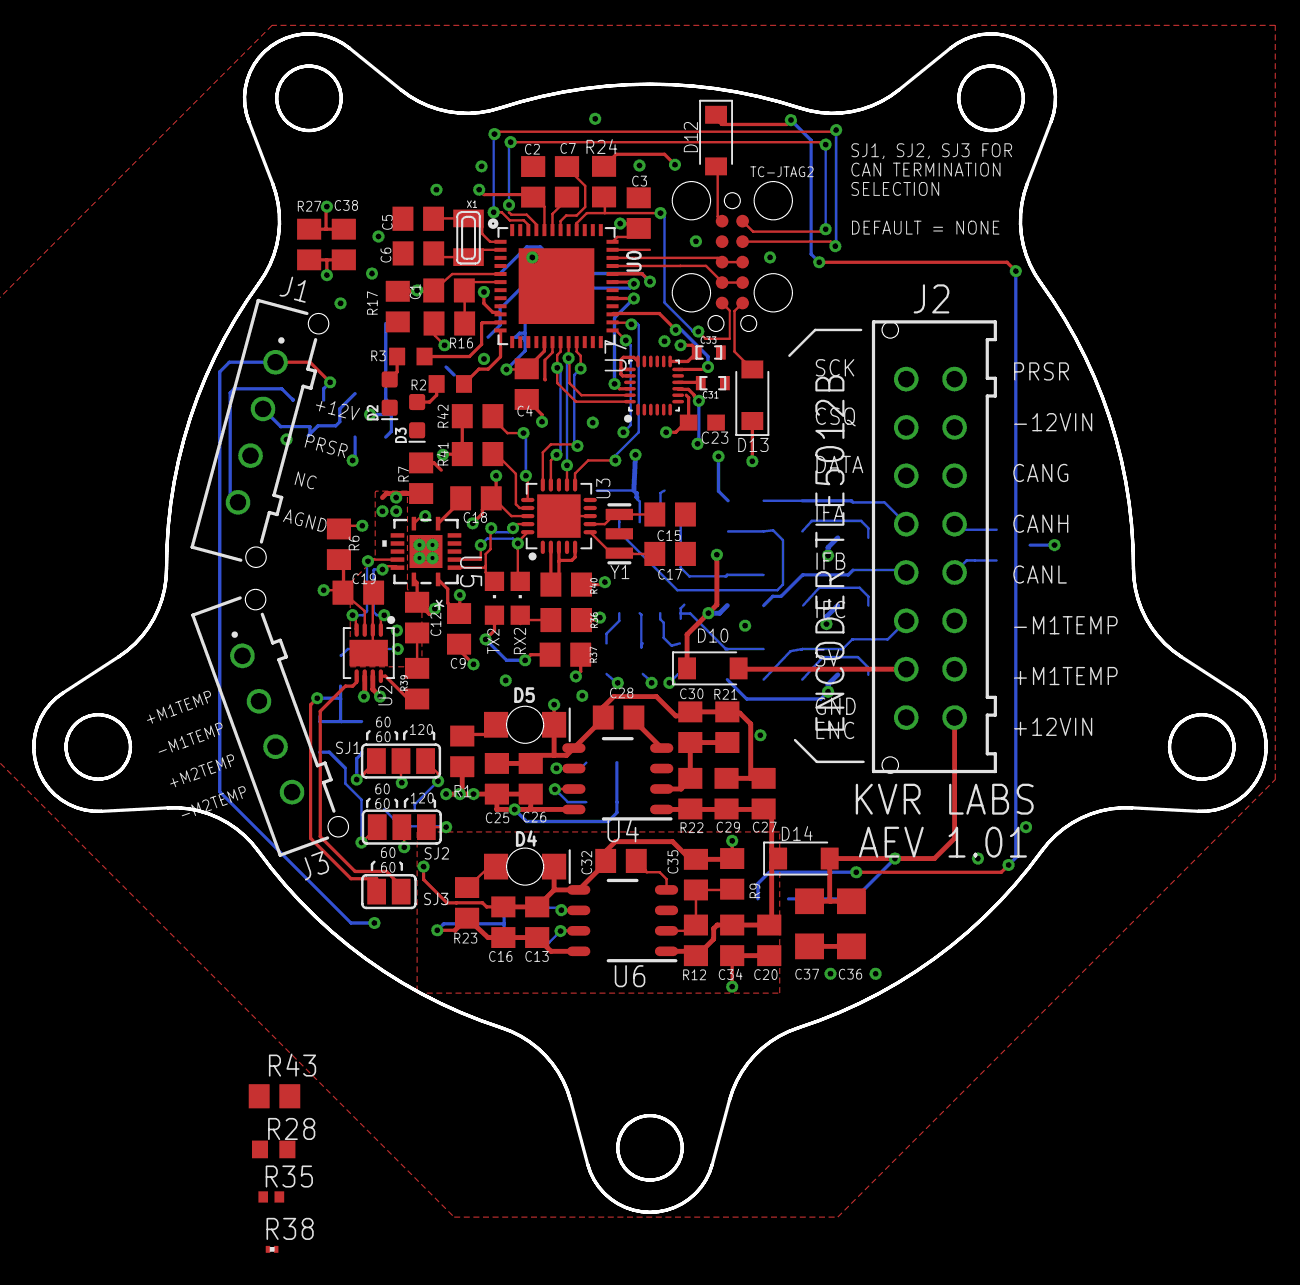
[picture p45: board On Axis Encoder.brd from above]

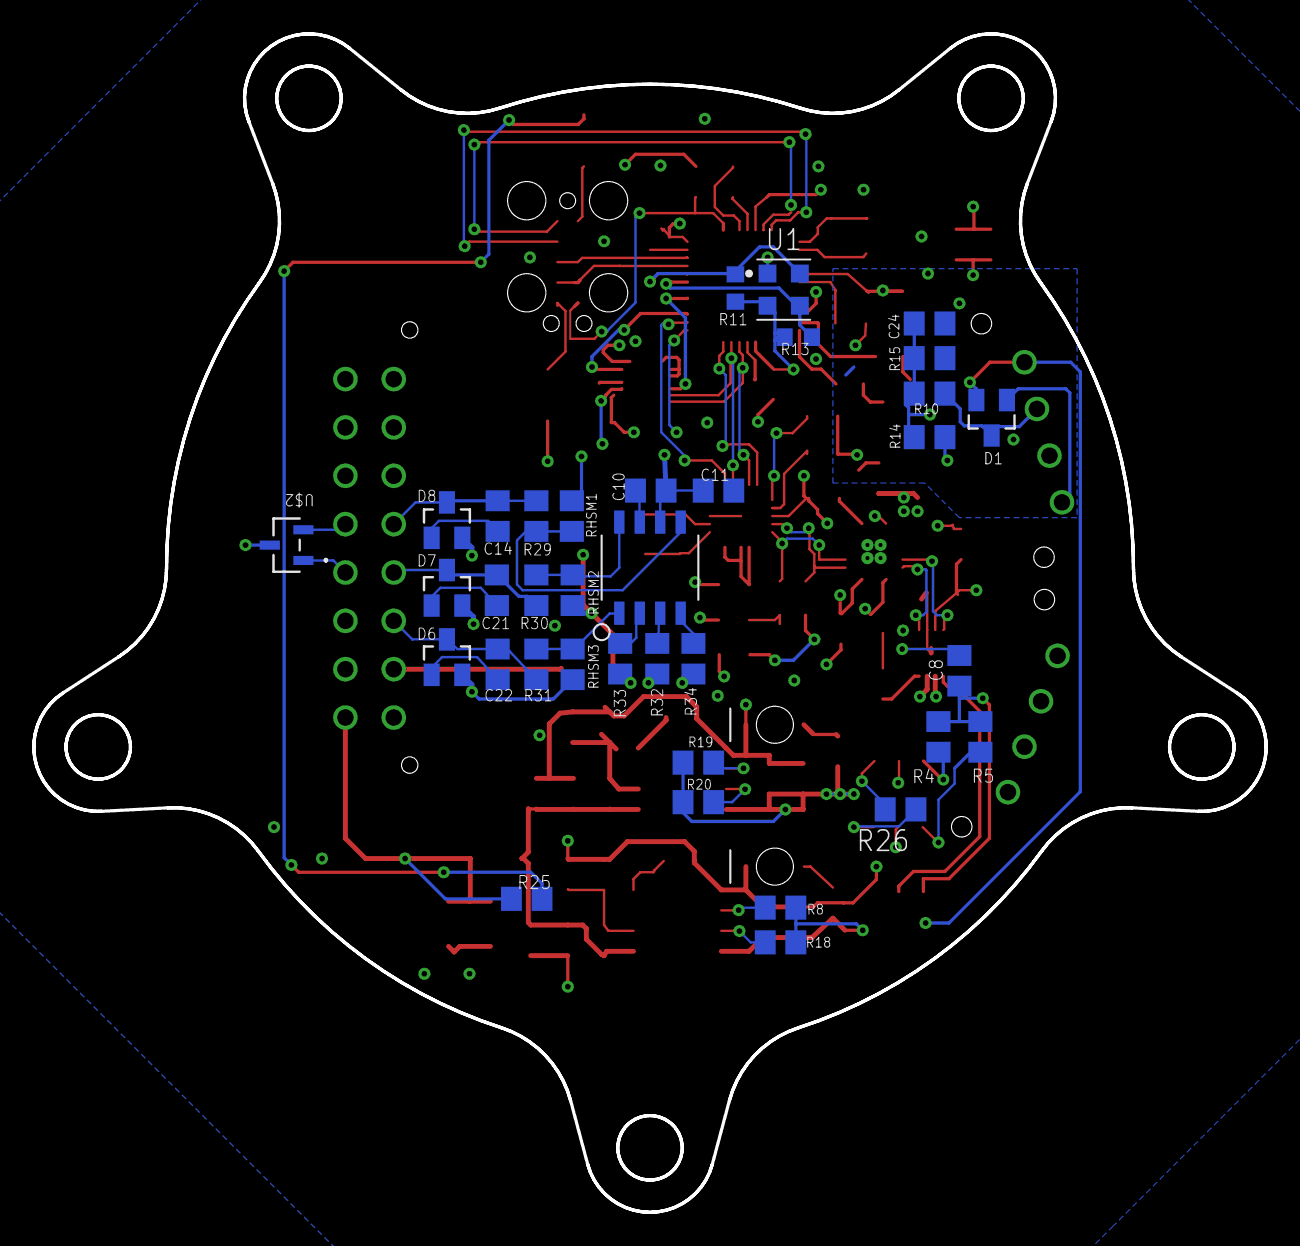
[picture p46: board On Axis Encoder.brd from below]

Board: 4 copper layers, 76.5 x 73.1 mm, 117 parts (36 on the bottom side), 84 nets.
