aleckorver/KVR-ENCDR/SAMD21G18/Single Side Board/EAGLE/On Axis Encoder - Single Side.brd

## EAGLE design SAMD21G18/Single Side Board/EAGLE/On Axis Encoder - Single Side.brd (2020-12-15)

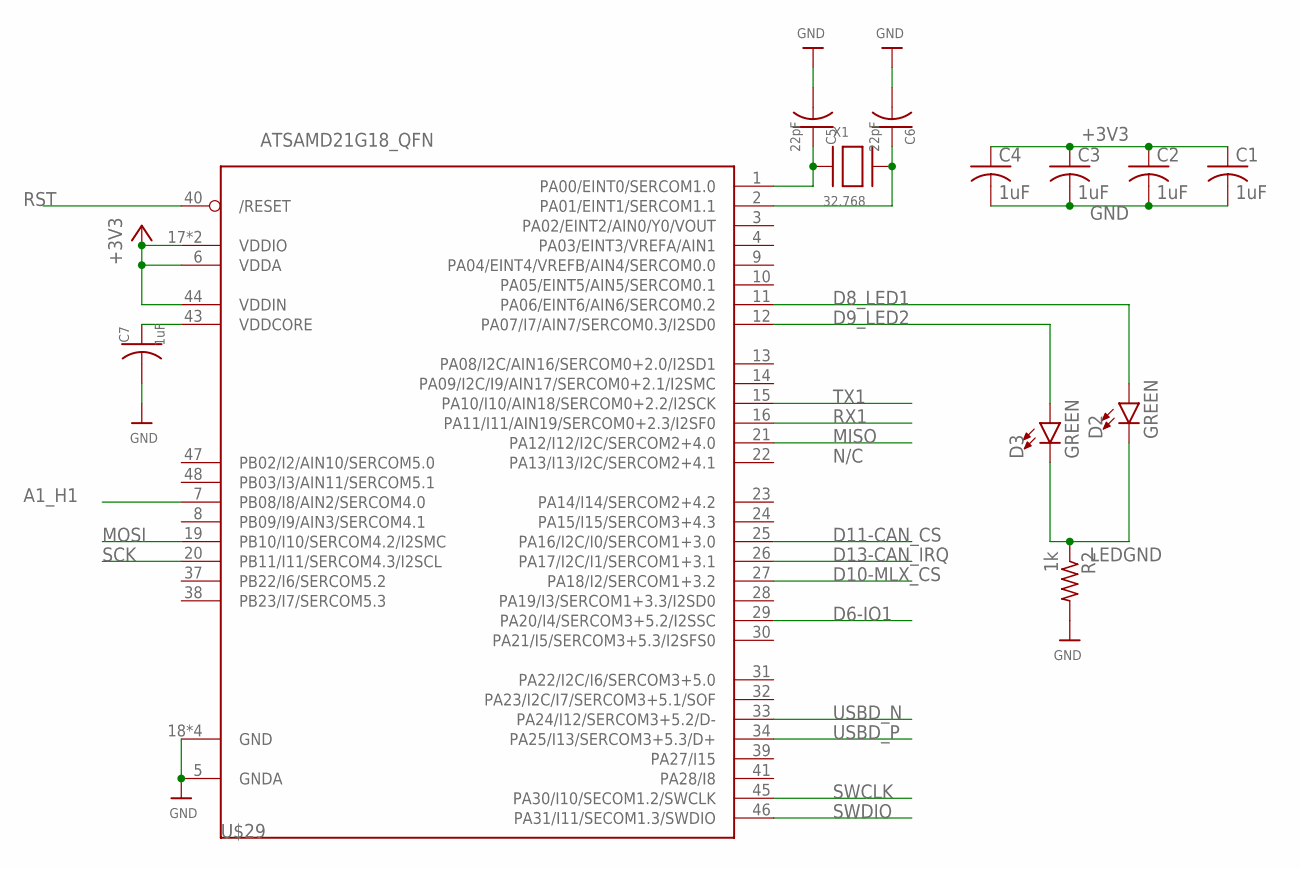
[picture p47: schematic On Axis Encoder - Single Side.sch, sheet 1, MCU]

Parts:
C1, C2, C3, C4, C7: 1uF; C0603
C5, C6: 22pF; C0603
D2, D3: GREEN; LED-0603
R2: 1k; R0603
U$29: ATSAMD21G18_QFN; MICROBUILDER_TQFN48_7MM
X1: 32.768; XTAL3215

Connections:
+3V3: C1.1, C2.1, C3.1, C4.1, U$29.6 (VDDA), U$29.17 (VDDIO), U$29.36 (VDDIO), U$29.44 (VDDIN); also elsewhere on the board
A1_H1: U$29.7 (PB08/I8/AIN2/SERCOM4.0); also elsewhere on the board
D6-IO1: U$29.29 (PA20/I4/SERCOM3+5.2/I2SSC); also elsewhere on the board
D8_LED1: D2.A, U$29.11 (PA06/EINT6/AIN6/SERCOM0.2)
D9_LED2: D3.A, U$29.12 (PA07/I7/AIN7/SERCOM0.3/I2SD0)
D10-MLX_CS: U$29.27 (PA18/I2/SERCOM1+3.2); also elsewhere on the board
D11-CAN_CS: U$29.25 (PA16/I2C/I0/SERCOM1+3.0); also elsewhere on the board
D13-CAN_IRQ: U$29.26 (PA17/I2C/I1/SERCOM1+3.1); also elsewhere on the board
GND: C1.2, C2.2, C3.2, C4.2, C5.2, C6.2, C7.2, R2.2, U$29.5 (GNDA), U$29.18 (GND), U$29.35 (GND), U$29.42 (GND), U$29.THERMAL (GND); also elsewhere on the board
LEDGND: D2.C, D3.C, R2.1; also elsewhere on the board
MISO: U$29.21 (PA12/I12/I2C/SERCOM2+4.0); also elsewhere on the board
MOSI: U$29.19 (PB10/I10/SERCOM4.2/I2SMC); also elsewhere on the board
unnamed: C5.1, U$29.1 (PA00/EINT0/SERCOM1.0), X1.P$1
unnamed: C6.1, U$29.2 (PA01/EINT1/SERCOM1.1), X1.P$2
RST: U$29.40 (/RESET); also elsewhere on the board
RX1: U$29.16 (PA11/I11/AIN19/SERCOM0+2.3/I2SF0)
SCK: U$29.20 (PB11/I11/SERCOM4.3/I2SCL); also elsewhere on the board
SWCLK: U$29.45 (PA30/I10/SECOM1.2/SWCLK); also elsewhere on the board
SWDIO: U$29.46 (PA31/I11/SECOM1.3/SWDIO); also elsewhere on the board
TX1: U$29.15 (PA10/I10/AIN18/SERCOM0+2.2/I2SCK)
USBD_N: U$29.33 (PA24/I12/SERCOM3+5.2/D-); also elsewhere on the board
USBD_P: U$29.34 (PA25/I13/SERCOM3+5.3/D+); also elsewhere on the board
VDDCORE2: C7.1, U$29.43 (VDDCORE)

Notes on the sheet:
N/C

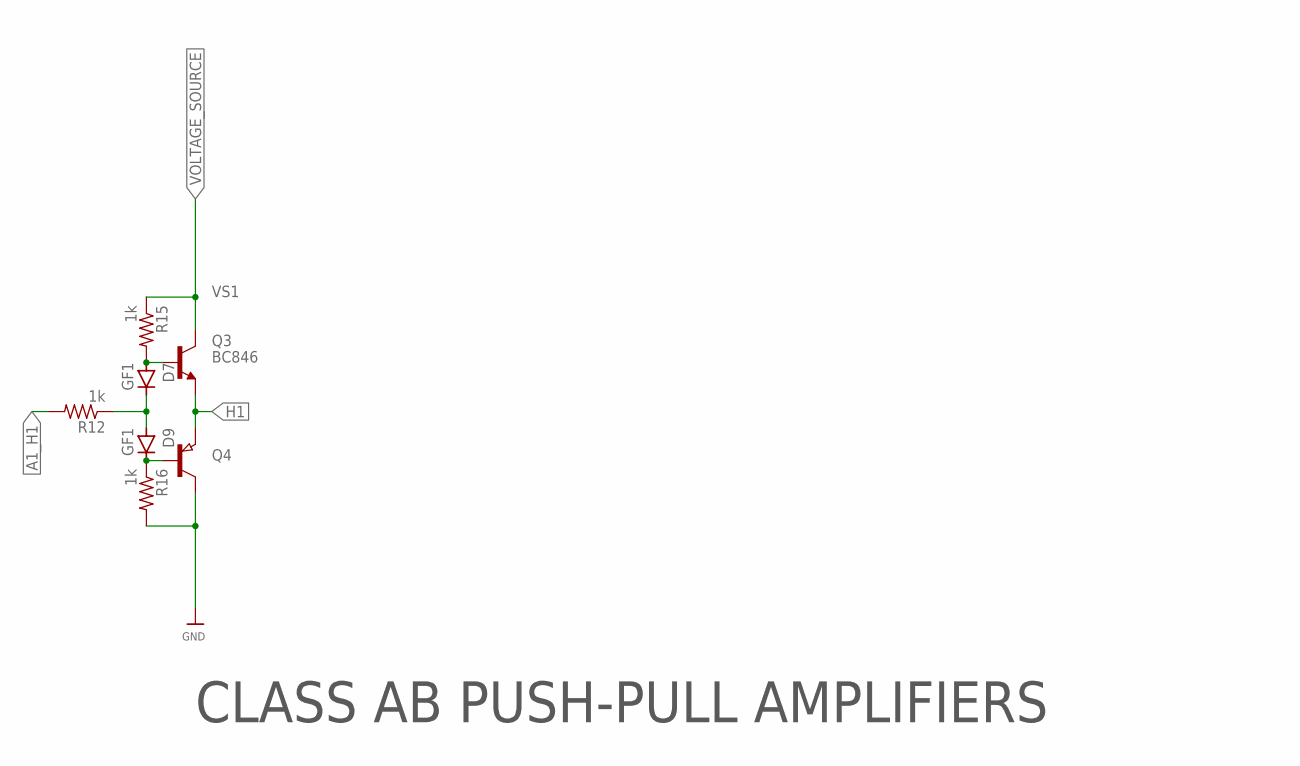
[picture p48: schematic On Axis Encoder - Single Side.sch, sheet 2, PUSH-PULL OUTPUTS]

Parts:
D7, D9: GF1; SMA-DO214AC
Q3: BC846; SOT23
Q4: PNP-TRANSISTOR_SOT23; SOT23
R12, R15, R16: 1k; R0603

Connections:
A1_H1: R12.2; also elsewhere on the board
GND: Q4.3 (C), R16.2; also elsewhere on the board
H1: Q3.2 (E), Q4.2 (E); also elsewhere on the board
unnamed: D9.K (C), Q4.1 (B), R16.1
unnamed: D7.A, Q3.1 (B), R15.2
unnamed: D7.K (C), D9.A, R12.1
VS1: Q3.3 (C), R15.1

Notes on the sheet:
CLASS AB PUSH-PULL AMPLIFIERS
