aleckorver/KVR-ENCDR/SAMD21G18/Single Side Board/EAGLE/On Axis Encoder - Single Side.brd

## EAGLE design SAMD21G18/Single Side Board/EAGLE/On Axis Encoder - Single Side.brd (continued)

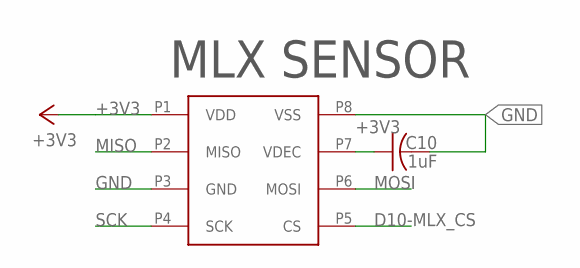
[picture p49: schematic On Axis Encoder - Single Side.sch, sheet 3, MLX Triaxis Hall Effect Sensor]

Parts:
C10: 1uF; C0603
U$4: MLX90363-SOIC8; SOIC-8

Connections:
+3V3: C10.1, U$4.P1 (VDD), U$4.P7 (VDEC); also elsewhere on the board
D10-MLX_CS: U$4.P5 (CS); also elsewhere on the board
GND: C10.2, U$4.P3 (GND), U$4.P8 (VSS); also elsewhere on the board
MISO: U$4.P2 (MISO); also elsewhere on the board
MOSI: U$4.P6 (MOSI); also elsewhere on the board
SCK: U$4.P4 (SCK); also elsewhere on the board

Notes on the sheet:
MLX SENSOR

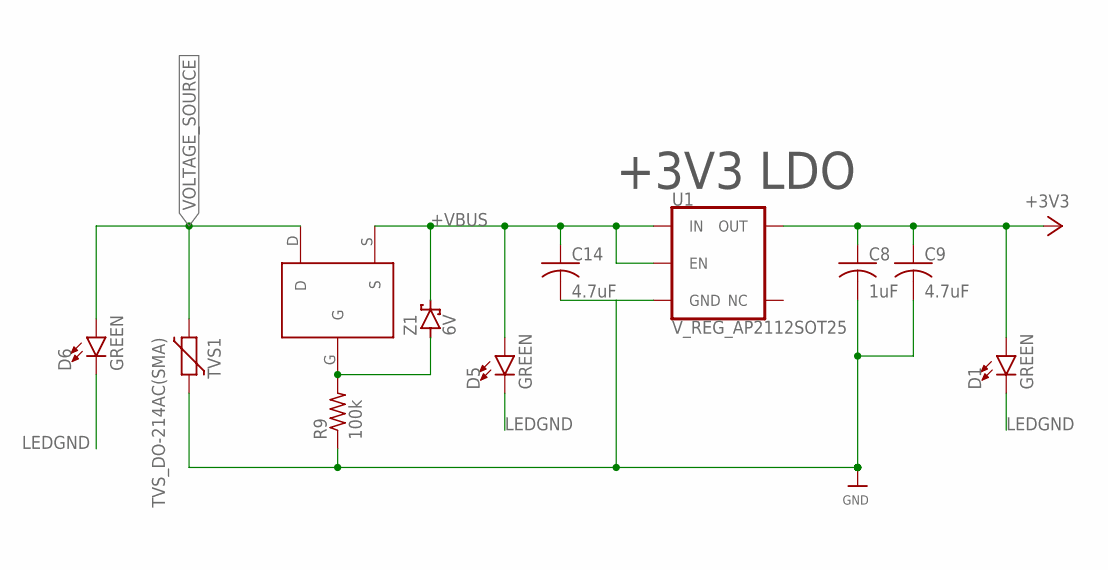
[picture p50: schematic On Axis Encoder - Single Side.sch, sheet 4, Voltage Regulator]

Parts:
C8: 1uF; C0603
C9, C14: 4.7uF; C0603
D1, D5, D6: GREEN; LED-0603
PFET1: PFET; SOT323-3_NFET
R9: 100k; R0603
TVS1: TVS_DO-214AC(SMA); DIOM5226X290N
U1: V_REG_AP2112SOT25; SOT95P285X140-5N
Z1: 6V; SOT23

Connections:
+3V3: C8.1, C9.1, D1.A, U1.5 (OUT); also elsewhere on the board
+VBUS: C14.1, D5.A, PFET1.S, U1.1 (IN), U1.3 (EN), Z1.3 (C); also elsewhere on the board
GND: C8.2, C9.2, C14.2, R9.1, TVS1.2, U1.2 (GND); also elsewhere on the board
LEDGND: D1.C, D5.C, D6.C; also elsewhere on the board
unnamed: PFET1.G, R9.2, Z1.1 (A)
VOLTAGE_SOURCE: D6.A, PFET1.D, TVS1.1; also elsewhere on the board

Notes on the sheet:
+3V3 LDO

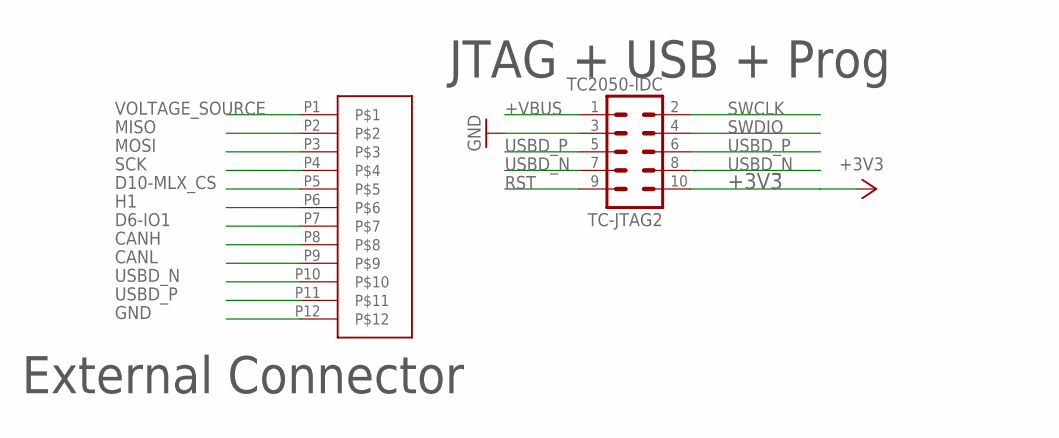
[picture p51: schematic On Axis Encoder - Single Side.sch, sheet 5, Connectors]

Parts:
TC-JTAG2: TC2050-IDC
U$9: BM12B-ZESS-TBT; JST-BM12B-ZESS-TBT

Connections:
+3V3: TC-JTAG2.10; also elsewhere on the board
+VBUS: TC-JTAG2.1; also elsewhere on the board
CANH: U$9.P8; also elsewhere on the board
CANL: U$9.P9; also elsewhere on the board
D6-IO1: U$9.P7; also elsewhere on the board
D10-MLX_CS: U$9.P5; also elsewhere on the board
GND: TC-JTAG2.3, U$9.P12; also elsewhere on the board
H1: U$9.P6; also elsewhere on the board
MISO: U$9.P2; also elsewhere on the board
MOSI: U$9.P3; also elsewhere on the board
RST: TC-JTAG2.9; also elsewhere on the board
SCK: U$9.P4; also elsewhere on the board
SWCLK: TC-JTAG2.2; also elsewhere on the board
SWDIO: TC-JTAG2.4; also elsewhere on the board
USBD_N: TC-JTAG2.7, TC-JTAG2.8, U$9.P10; also elsewhere on the board
USBD_P: TC-JTAG2.5, TC-JTAG2.6, U$9.P11; also elsewhere on the board
VOLTAGE_SOURCE: U$9.P1; also elsewhere on the board

Notes on the sheet:
JTAG + USB + Prog
External Connector

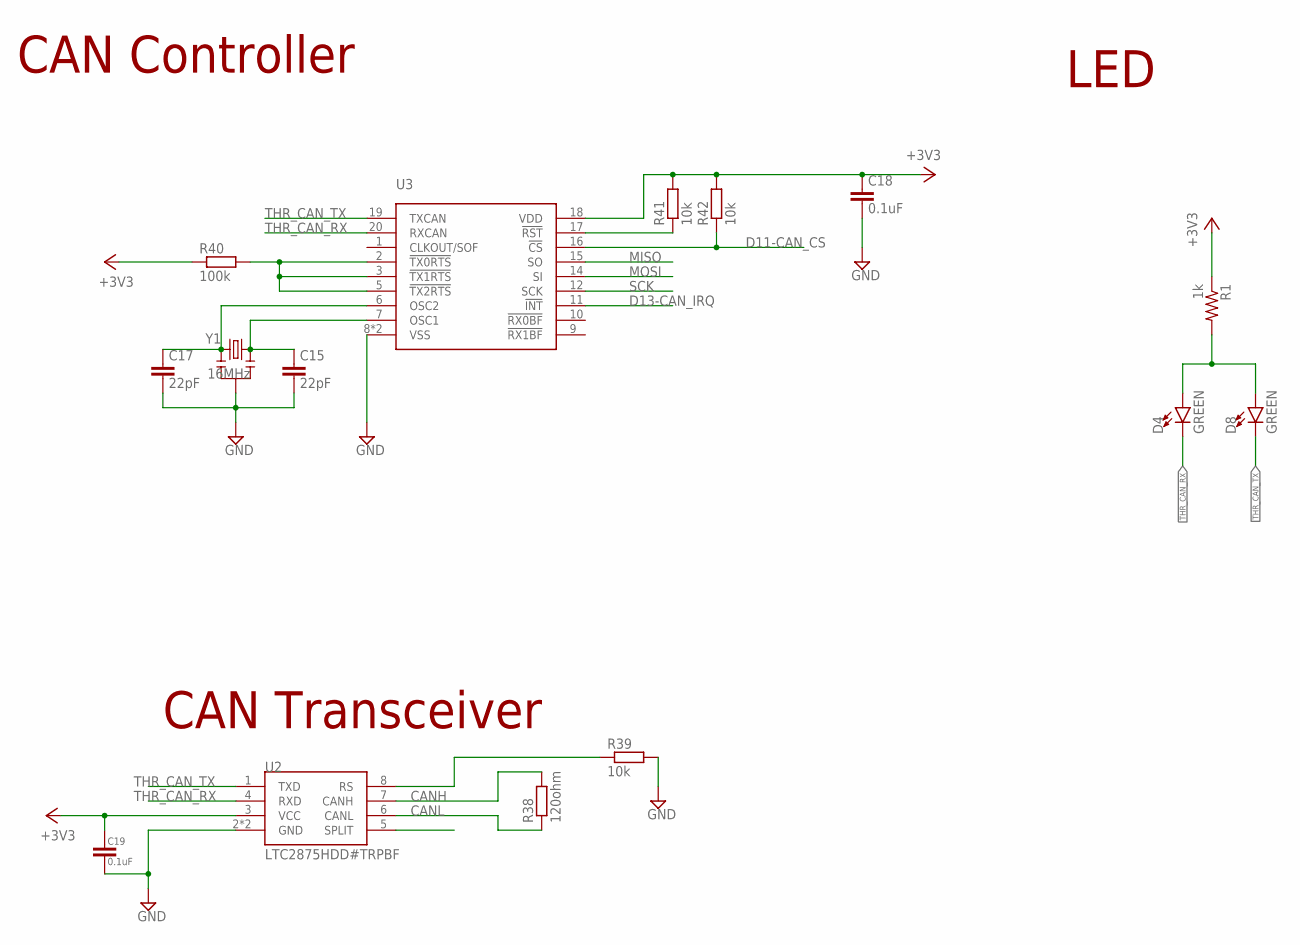
[picture p52: schematic On Axis Encoder - Single Side.sch, sheet 6, CANbus]

Parts:
C15, C17: 22pF; C-0603
C18, C19: 0.1uF; C-0603
D4, D8: GREEN; LED-0603
R1: 1k; R0603
R38: 120ohm; R-0603
R39, R41, R42: 10k; R-0603
R40: 100k; R-0603
U2: LTC2875HDD#TRPBF; SON50P300X300X80-9T165X238N
U3: MCP2515-E/ML; QFN50P400X400X100-21T270N
Y1: 16MHz; RESONATOR-SMD

Connections:
+3V3: C18.P$1 (1), C19.P$1 (1), R1.1, R40.P$1 (1), R41.P$2 (2), R42.P$2 (2), U2.3 (VCC), U3.18 (VDD); also elsewhere on the board
CANH: R38.P$2 (2), U2.7 (CANH); also elsewhere on the board
CANL: R38.P$1 (1), U2.6 (CANL); also elsewhere on the board
D11-CAN_CS: R42.P$1 (1), U3.16 (!CS); also elsewhere on the board
D13-CAN_IRQ: U3.11 (!INT); also elsewhere on the board
GND: C15.P$2 (2), C17.P$2 (2), C18.P$2 (2), C19.P$2 (2), R39.P$2 (2), U2.2 (GND), U2.9 (GND), U3.8 (VSS), U3.21 (VSS), Y1.2; also elsewhere on the board
MISO: U3.15 (SO); also elsewhere on the board
MOSI: U3.14 (SI); also elsewhere on the board
unnamed: D4.A, D8.A, R1.2
unnamed: R39.P$1 (1), U2.8 (RS)
unnamed: R41.P$1 (1), U3.17 (!RST)
unnamed: R40.P$2 (2), U3.2 (!TX0RTS), U3.3 (!TX1RTS), U3.5 (!TX2RTS)
unnamed: C17.P$1 (1), U3.6 (OSC2), Y1.3
unnamed: C15.P$1 (1), U3.7 (OSC1), Y1.1
SCK: U3.12 (SCK); also elsewhere on the board
THR_CAN_RX: D4.C, U2.4 (RXD), U3.20 (RXCAN)
THR_CAN_TX: D8.C, U2.1 (TXD), U3.19 (TXCAN)

Notes on the sheet:
CAN Transceiver
CAN Controller
LED

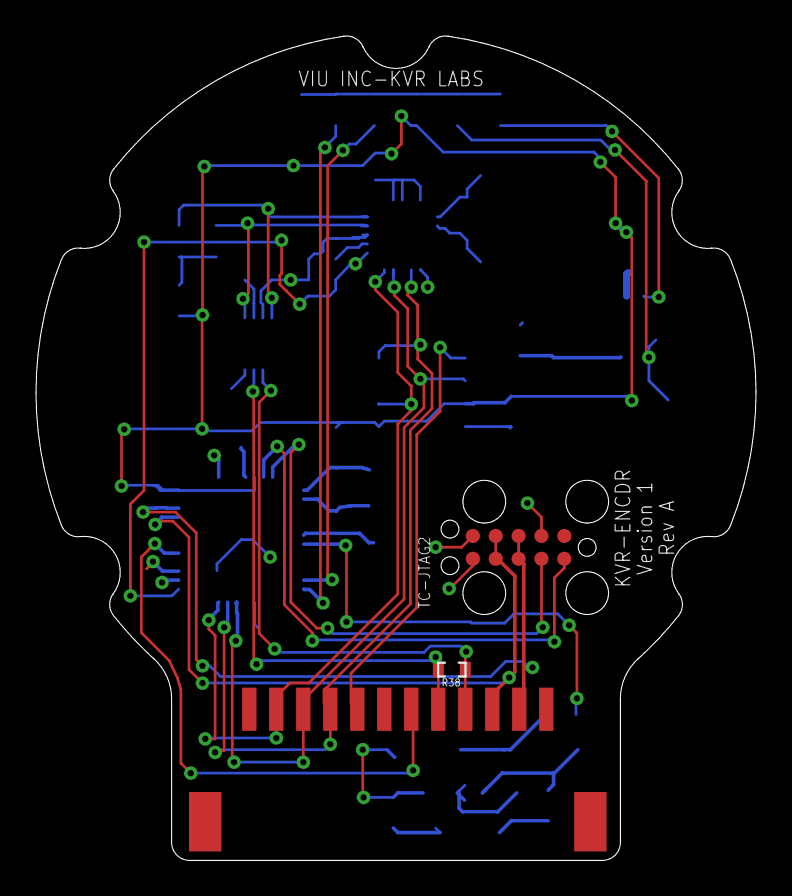
[picture p53: board On Axis Encoder - Single Side.brd from above]

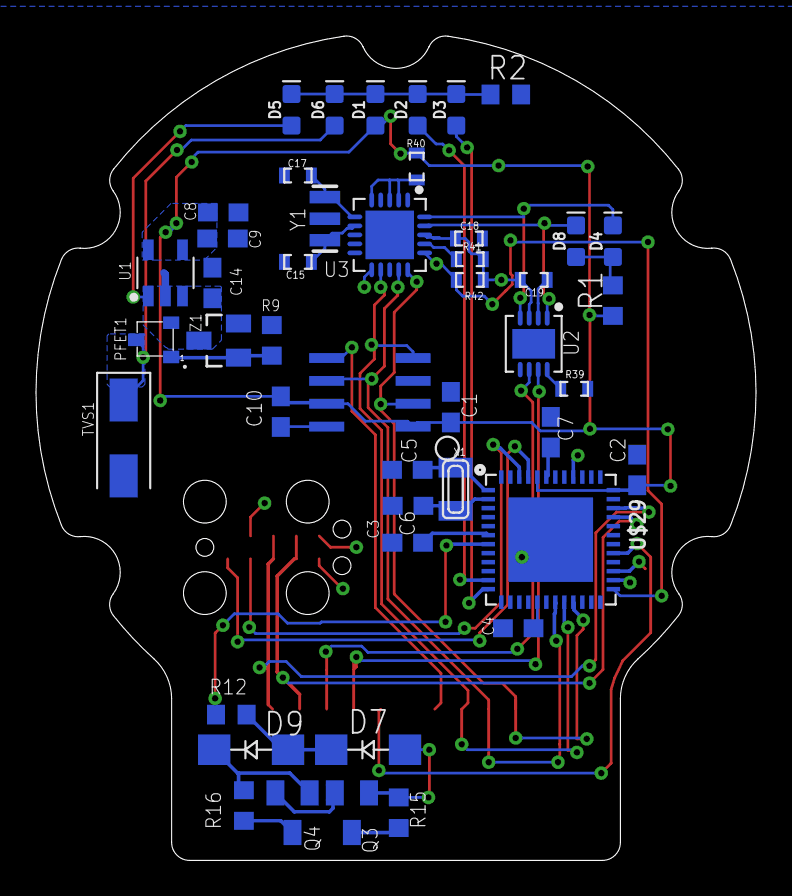
[picture p54: board On Axis Encoder - Single Side.brd from below]

Board: 4 copper layers, 40.0 x 45.8 mm, 49 parts (46 on the bottom side), 39 nets.
