aleckorver/KVR-ENCDR/STM32/Firmware/Example/melexis.h

/*
	MELEXIS.h - MELEXIS library

	For interfacing with the MLX90363 triaxis hall effect sensor
	
	by Travis Howse <tjhowse@gmail.com>
	2012.   License, GPL v2 or later

*/

#ifndef MELEXIS_h
#define MELEXIS_h

#include <inttypes.h>


class MELEXIS
{
	public:
		int16_t get_x();
		int16_t get_y();
		int16_t get_z();
		uint8_t get_diag();
		uint16_t get_diag_0();
		uint16_t get_diag_1();
		uint8_t get_roll();
		uint8_t poll(bool cyberT);
		uint8_t diag_poll();
		uint8_t do_SPI();
		uint8_t reboot();
		void send_NOP();
    uint8_t get_footer();
    uint8_t get_diag_details1();
    uint8_t get_diag_details2();
		
		uint16_t set_eeprom(uint16_t addr, uint8_t offset, uint8_t length, uint16_t data);
		uint16_t get_eeprom(uint16_t addr, uint8_t offset, uint8_t length);
		uint16_t get_eeprom_word(uint16_t addr, uint8_t offset, uint8_t length);
		uint16_t get_EE_Key(uint16_t addr);

		MELEXIS(uint8_t selectPin);
	
	private:
		bool do_checksum(uint8_t* message);

};

#endif
