aleckorver/KVR-ENCDR/(commit log)

2020-05-03 Initial Commit
    Initial Commit of hardware and firmware (IN ACTIVE DEVELOPMENT)
    [On Axis Encoder - Single Side.brd, On Axis Encoder - Single Side.sch, On Axis Encoder.brd, On Axis Encoder.sch]
2020-12-15 Updated STM32
    [KVR LABS - AEV ENCODER 1.01-SAMD21G18.brd, KVR LABS - AEV ENCODER 1.01-SAMD21G18.sch, KVR LABS - AEV ENCODER 1.01-STM32.brd, KVR LABS - AEV ENCODER 1.01-STM32.sch, KVR LABS - AEV ENCODER 1.01.brd, KVR LABS - AEV ENCODER 1.01.sch, On Axis Encoder.dxf]
2020-12-28 Updated Schematic and layout
    [AEV ENC 0.0.1 - 201209.step, AEV ENCODER 0.0.1 201219.step, KVR LABS - AEV ENCODER 1.01-STM32.brd, KVR LABS - AEV ENCODER 1.01-STM32.sch]
